NVSL/Quadcopters/Class/Tutorial Photos/2-16.png

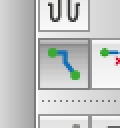
Class/Tutorial Photos/2-16.png
