NVSL/Quadcopters/Class/Tutorial Photos/2-14.png

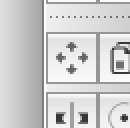
Class/Tutorial Photos/2-14.png
