NVSL/Quadcopters/Class/Slides/04_layers and CAM.pptx

## Layers and CAM

## Layers

- Eagle (and other board design tools) use layers to specify different types of information about a board. E.g:
  - Where wires should go on each physical layer
  - Where wires should not go on each physical layer
  - Documentation
  - Mechanical information
- Eagle defines 52 layers by default
- ‘t’ prefix means top.
- ‘b’ prefix means bottom (displayed mirrored)

## Eagle Layers

Top | Tracks, top side | | 27 | tValues | Component VALUE, top side
Route2 | Inner layer | | 28 | bValues | Component VALUE, bottom side
Route3 | Inner layer | | 29 | tStop | Solder stop mask, top side (gen. autom.) | | Design
Route4 | Inner layer | | 30 | bStop | Solder stop mask, bottom side (gen. Autom.) | | Documentation
Route5 | Inner layer | | 31 | tCream | Solder cream, top side | | Tool guidance
Route6 | Inner layer | | 32 | bCream | Solder cream, bottom side
Route7 | Inner layer | | 33 | tFinish | Finish, top side
Route8 | Inner layer | | 34 | bFinish | Finish, bottom side
Route9 | Inner layer | | 35 | tGlue | Glue mask, top side
Route10 | Inner layer | | 36 | bGlue | Glue mask, bottom side
Route11 | Inner layer | | 37 | tTest | Test and adjustment information, top side
Route12 | Inner layer | | 38 | bTest | Test and adjustment inf., bottom side
Route13 | Inner layer | | 39 | tKeepout | Restricted areas for components, top side
Route14 | Inner layer | | 40 | bKeepout | Restricted areas for components, bottom s.
Route15 | Inner layer | | 41 | tRestrict | Restricted areas for copper, top side
Bottom | Tracks, bottom side | | 42 | bRestrict | Restricted areas for copper, bottom side
Pads | Pads (through-hole) | | 43 | vRestrict | Restricted areas for vias
Vias | Vias (through all layers) | | 44 | Drills | Conducting through-holes
Unrouted | Airlines (rubber bands) | | 45 | Holes | Non-conducting holes
Dimension | Board outlines (circles for holes) *) | | 46 | Milling | Milling
tPlace | Silk screen, top side | | 47 | Measures | Measures
bPlace | Silk screen, bottom side | | 48 | Document | Documentation
tOrigins | Origins, top side (generated autom.) | | 49 | Reference | Reference marks
bOrigins | Origins, bottom side (generated autom.) | | 51 | tDocu | Detailed top screen print
tNames | Service print, top side (component NAME) | | 52 | bDocu | Detailed bottom screen print
bNames | Service print, bottom s. (component NAME)

## Layer Demo

## Layers In Packages

- Packages have layers too, but not all of them
  - E.g. no inner metal layers
- For packages “t” means device side, “b” means opposite side.
- If you put the devices on the back side of the board, “t” and “b” will swap.

## CAM Layers (Gerber files)

- Eagle layers are for design.
- CAM layers are for manufacturing
  - “Gerber” files are for lithographic steps
  - Drill files are for drilling holes.
- Each CAM layers corresponds to one layer of the resulting board
  - Top silk screen
  - Top solder mask
  - Top metal
  - Inner metal layers
  - Bottom metal
  - Bottom solder mask
  - Bottom silk screen
- One drill file specifying where all the pads, vias, and mounting holes are located and their diameters
- Other files too, depending on the manufacturing process
  - Solder paste stencil
  - Assembly drawings

## The CAM Processor

- The CAM Processor generates CAM files
- The exact configuration for the gerber files varies by board house
  - Should the board outline be in every layer?
  - Which format should the files be in (there are many)
  - Should the back side layers be mirrored?

## CAM Setup

- To prepare Gerbers for a particular board house, you need CAM setup files (*.cam for Eagle)
- This specifies how to generate each layer the board house needs.
- See example in Button and Light Tutorial.

## CAM Demo

## Checking Your Gerbers!

- Eagle can’t display Gerber files itself
- You need a 3rd party tool
  - See the Button and Light tutorial for recommendations
- You should always check your Gerbers!
  - Eagle has bugs (I assume)
  - You may have misconfigured something
  - You may have put something in the wrong layer.

## Gerber Viewer Demo

## DFM Checks

- You should also run a “design for manufacturing” (DFM) check on your Gerbers, if possible
- Freedfm.com will do this for you.

## FreeDFM Demo
