NVSL/Quadcopters/Master/Jorge/REV0/GERBER_master_jorge3newIMU/readme.txt

>Info
Board Name: UCSDQuadCop
Part Number: 0
Number of Layers: 2
X Dimension= 2.83 inch
Y Dimension= 2.90 inch
Board Material Type: FR-4
Solder Mask Color: Red
Silkscreen Color: White
Finish Plating: HASAL
Revision Number: 0
