NVSL/Quadcopters/Class/Slides/I2C.key/Data/pasted-image-190.tif

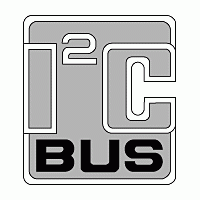
Class/Slides/I2C.key/Data/pasted-image-190.tif
