NVSL/Quadcopters/Class/Slides/I2C.key/Data/pasted-image-379.tif

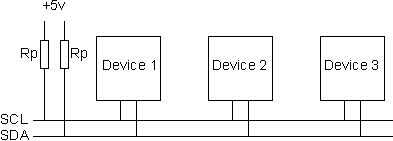
Class/Slides/I2C.key/Data/pasted-image-379.tif
