NVSL/Quadcopters/Class/Slides/I2C.key/Data/pasted-image-653.tif

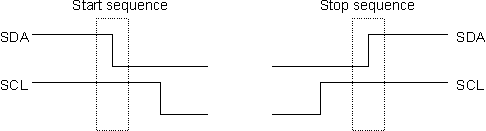
Class/Slides/I2C.key/Data/pasted-image-653.tif
