NVSL/Quadcopters/Class/Slides/I2C.key/Data/pasted-image-1346.tif

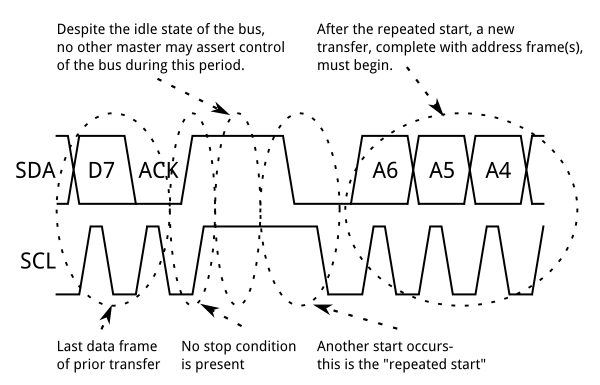
Class/Slides/I2C.key/Data/pasted-image-1346.tif
