NVSL/Quadcopters/Class/Slides/I2C.key/Data/pasted-image-small-1347.png

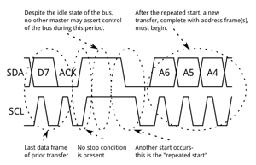
Class/Slides/I2C.key/Data/pasted-image-small-1347.png
