NVSL/Quadcopters/Class/Slides/I2C.key/Data/Screen Shot 2014-10-18 at 3.31.50 PM-908.png

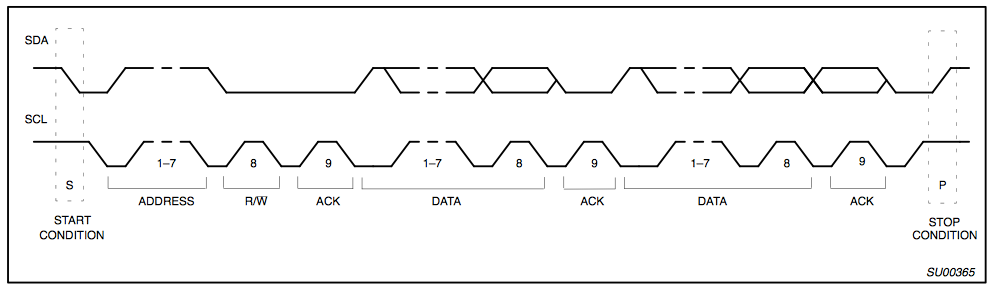
Class/Slides/I2C.key/Data/Screen Shot 2014-10-18 at 3.31.50 PM-908.png
