NVSL/Quadcopters/Class/Slides/I2C.key/Data/Screen Shot 2014-10-18 at 5.25.19 PM-1253.png

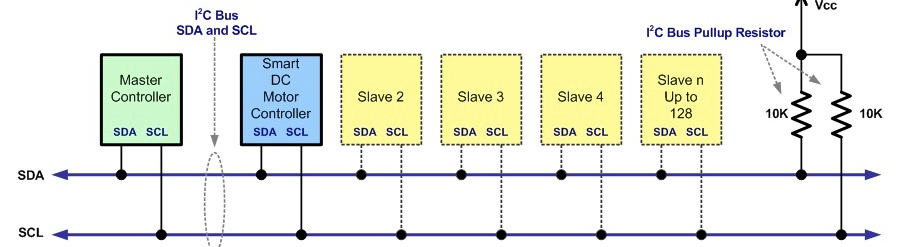
Class/Slides/I2C.key/Data/Screen Shot 2014-10-18 at 5.25.19 PM-1253.png
