NVSL/Quadcopters/Class/Slides/I2C.key/Data/st1-1359.jpg

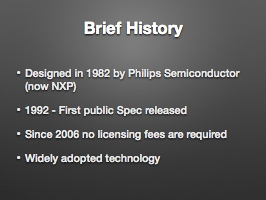
Class/Slides/I2C.key/Data/st1-1359.jpg
