NVSL/Quadcopters/Class/Slides/I2C.key/Data/st2-488.jpg

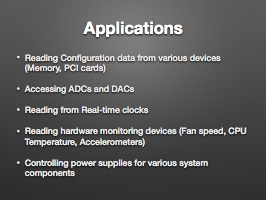
Class/Slides/I2C.key/Data/st2-488.jpg
