NVSL/Quadcopters/Class/Slides/I2C.key/Data/st4-532.jpg

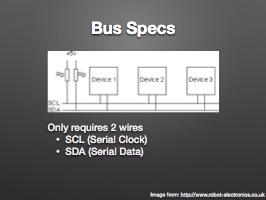
Class/Slides/I2C.key/Data/st4-532.jpg
