NVSL/Quadcopters/Class/Slides/I2C.key/Data/st6-1366.jpg

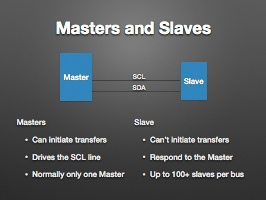
Class/Slides/I2C.key/Data/st6-1366.jpg
