NVSL/Quadcopters/Class/Slides/I2C.key/Data/st7-711.jpg

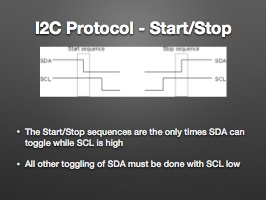
Class/Slides/I2C.key/Data/st7-711.jpg
