NVSL/Quadcopters/Class/Slides/I2C.key/Data/st8-843.jpg

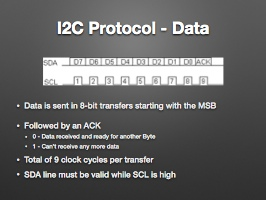
Class/Slides/I2C.key/Data/st8-843.jpg
