NVSL/Quadcopters/Class/Slides/I2C.key/Data/st9-896.jpg

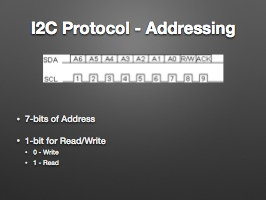
Class/Slides/I2C.key/Data/st9-896.jpg
