NVSL/Quadcopters/Class/Slides/I2C.key/Data/st10-1140.jpg

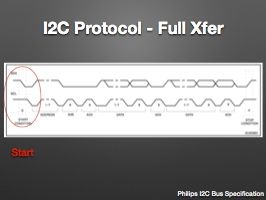
Class/Slides/I2C.key/Data/st10-1140.jpg
