NVSL/Quadcopters/Class/Slides/I2C.key/Data/st10-1331.jpg

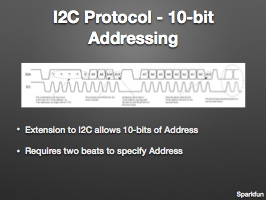
Class/Slides/I2C.key/Data/st10-1331.jpg
