NVSL/Quadcopters/Class/Slides/I2C.key/Data/st12-1098.jpg

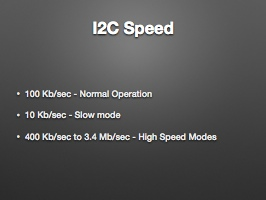
Class/Slides/I2C.key/Data/st12-1098.jpg
