NVSL/Quadcopters/Class/Slides/I2C.key/Data/st12-1168.jpg

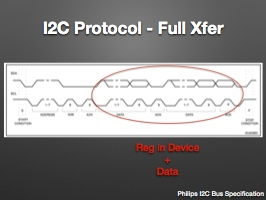
Class/Slides/I2C.key/Data/st12-1168.jpg
