NVSL/Quadcopters/Class/Slides/I2C.key/Data/st15-1349.jpg

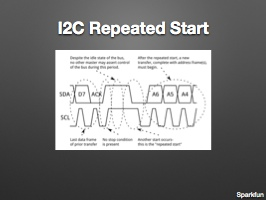
Class/Slides/I2C.key/Data/st15-1349.jpg
