NVSL/Quadcopters/Class/Slides/I2C.key/Data/st17-1248.jpg

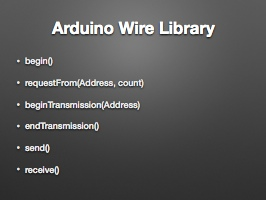
Class/Slides/I2C.key/Data/st17-1248.jpg
