NVSL/Quadcopters/Class/Slides/I2C.key/Data/st17-1279.jpg

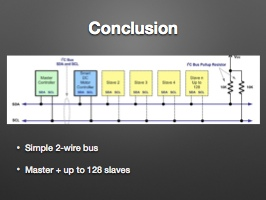
Class/Slides/I2C.key/Data/st17-1279.jpg
