NVSL/Quadcopters/Controller/controller_faceplate.dxf

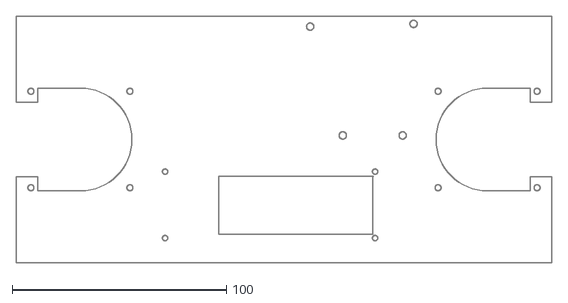
[picture p42: CAD file, 2015-02-03]
Controller/controller_faceplate.dxf
250.0 x 115.0
