NVSL/Quadcopters/Controller/Eagle/Projects/Controller_acrylic/controller_top.dxf

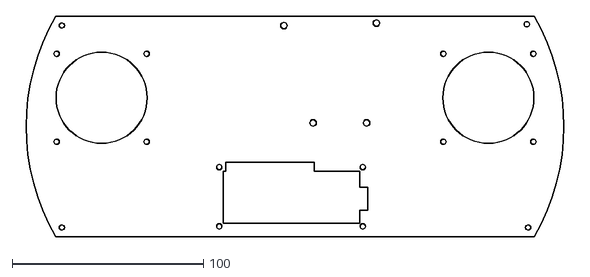
[picture p43: CAD file, 2015-03-24]
Controller/Eagle/Projects/Controller_acrylic/controller_top.dxf
291.1 x 115.0
