NVSL/Quadcopters/Controller/Eagle/Projects/Controller_acrylic/controller_bottom.dxf

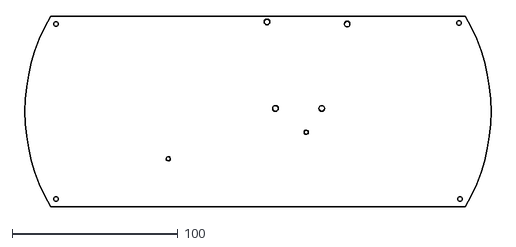
[picture p44: CAD file, 2015-03-24]
Controller/Eagle/Projects/Controller_acrylic/controller_bottom.dxf
291.1 x 115.0
