NVSL/Quadcopters/Class/Tutorial Photos/2-1.png

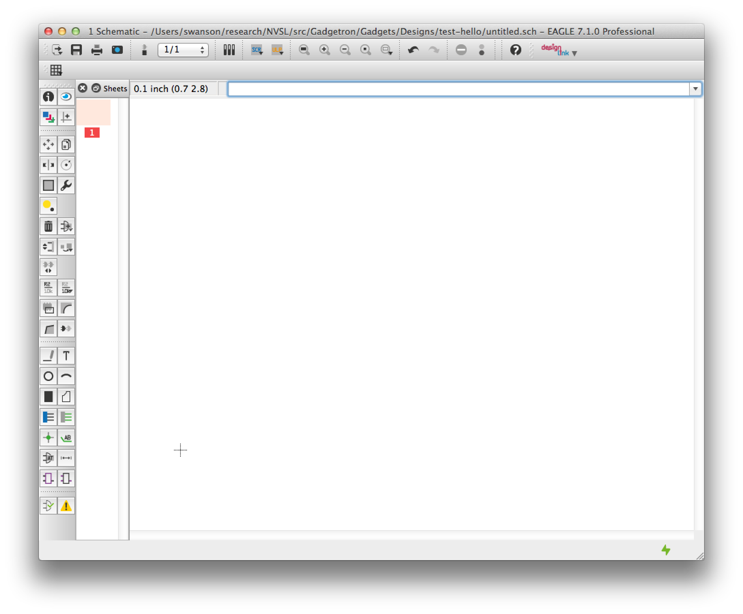
Class/Tutorial Photos/2-1.png
