NVSL/Quadcopters/Class/Tutorial Photos/2-3.png

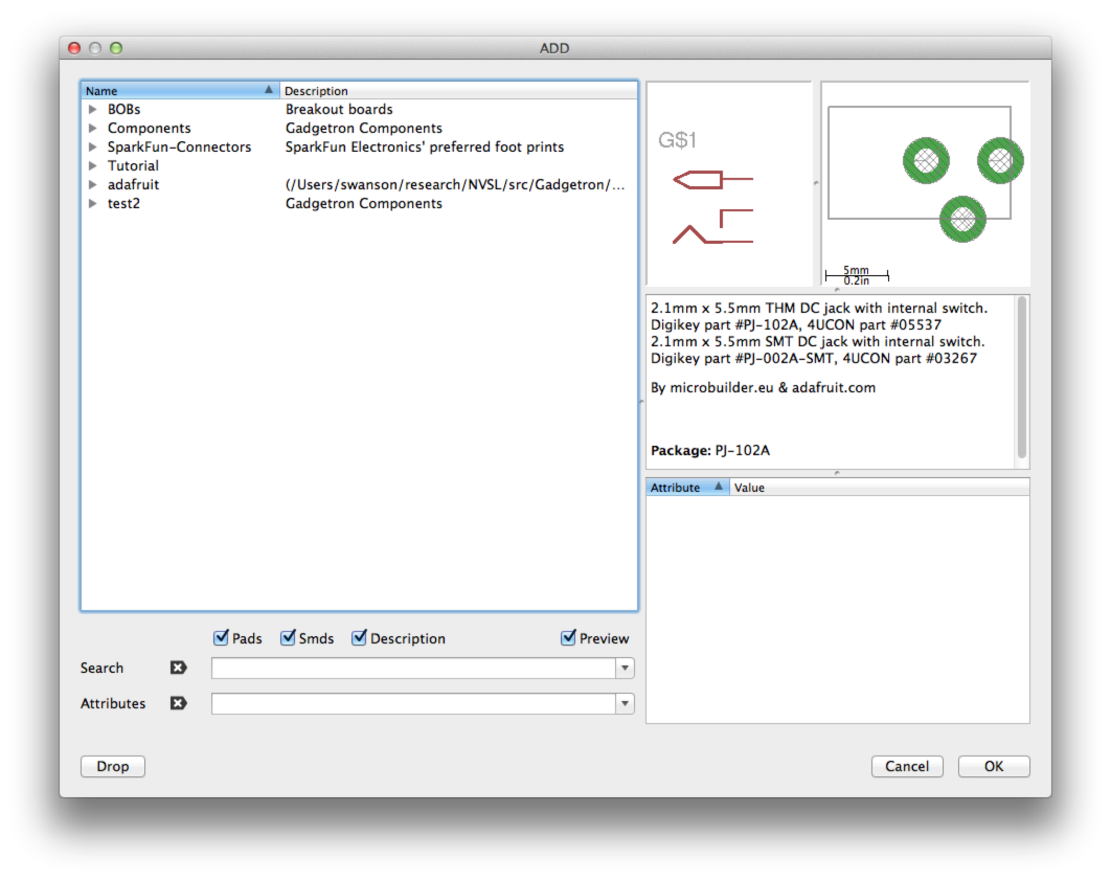
Class/Tutorial Photos/2-3.png
