NVSL/Quadcopters/Class/Tutorial Photos/2-4.png

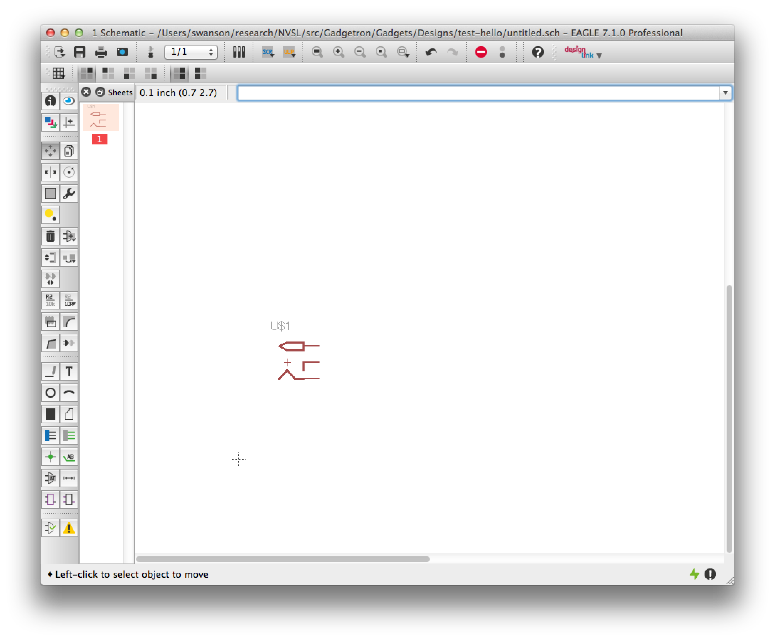
Class/Tutorial Photos/2-4.png
