NVSL/Quadcopters/Class/Tutorial Photos/2-5.png

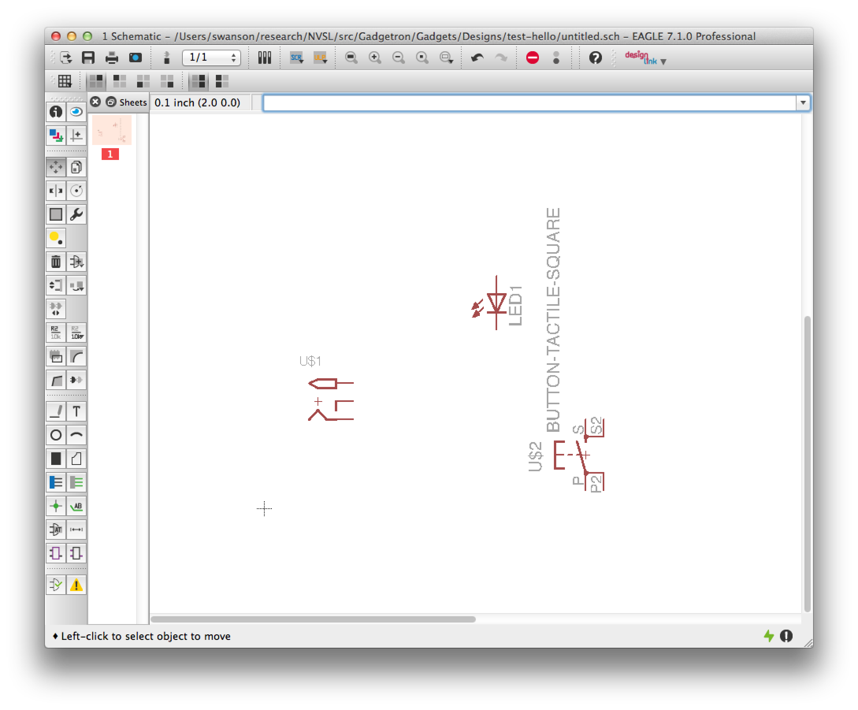
Class/Tutorial Photos/2-5.png
