NVSL/Quadcopters/Class/Tutorial Photos/2-7.png

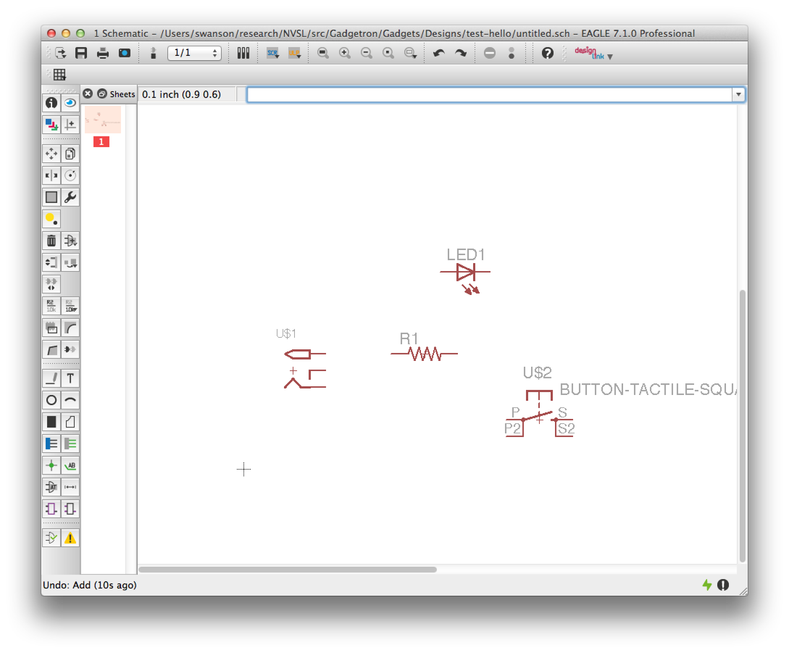
Class/Tutorial Photos/2-7.png
