NVSL/Quadcopters/Class/Tutorial Photos/2-12.png

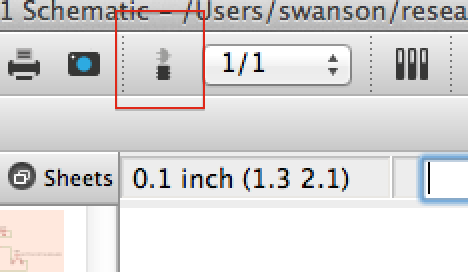
Class/Tutorial Photos/2-12.png
