NVSL/Quadcopters/Class/Tutorial Photos/2-13.png

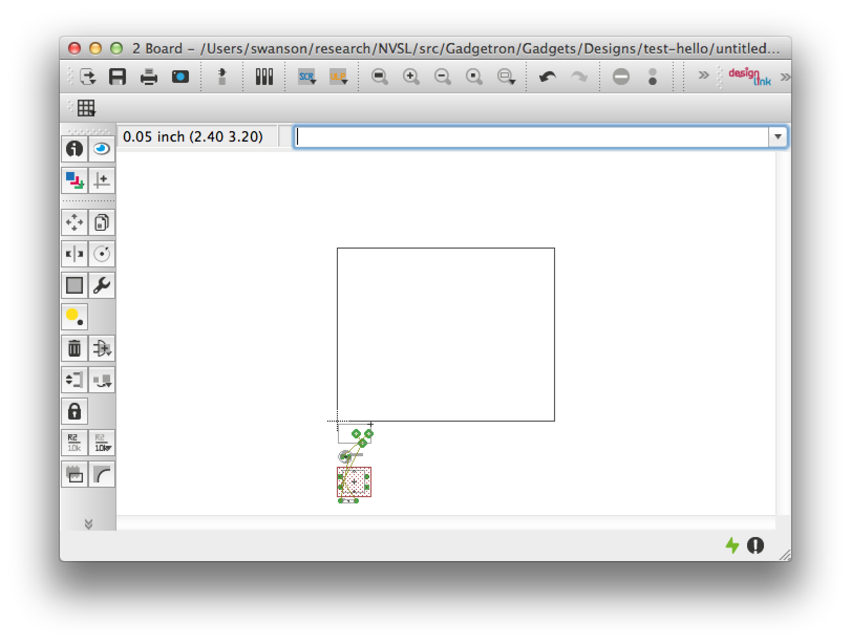
Class/Tutorial Photos/2-13.png
