NVSL/Quadcopters/Class/Tutorial Photos/2-15.png

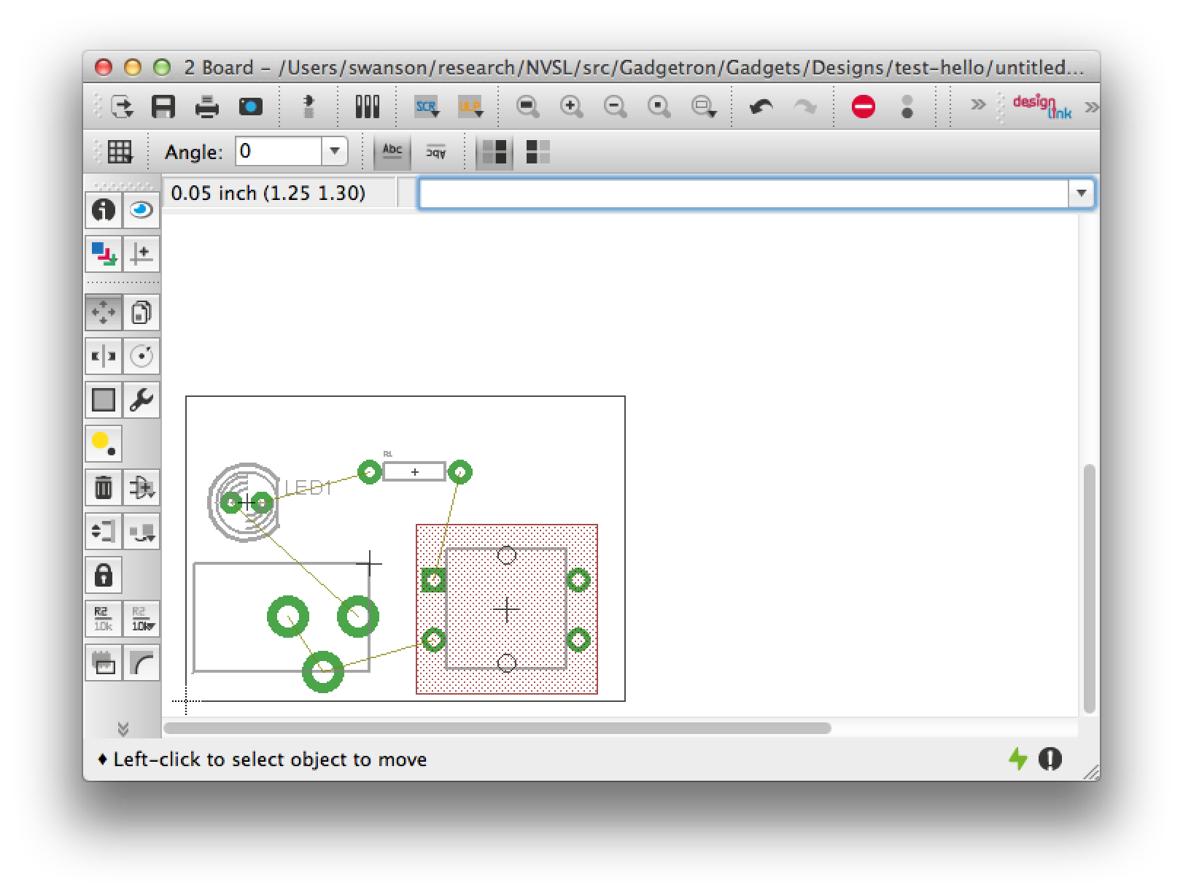
Class/Tutorial Photos/2-15.png
