NVSL/Quadcopters/Class/Tutorial Photos/2-17.png

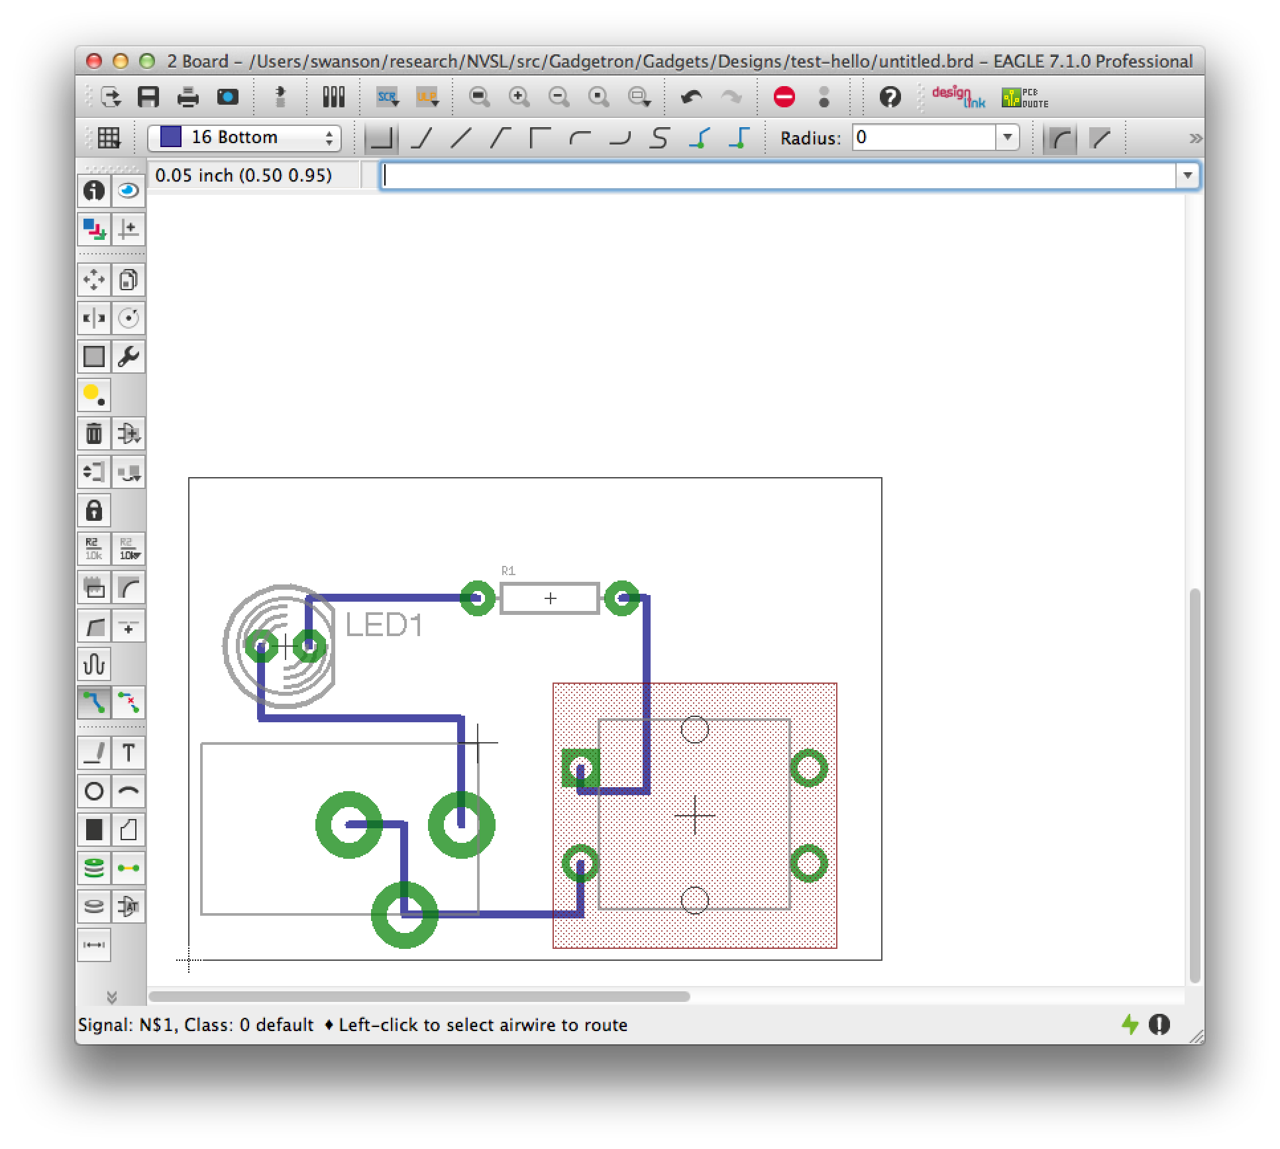
Class/Tutorial Photos/2-17.png
