NVSL/Quadcopters/Class/Tutorial Photos/2-18.png

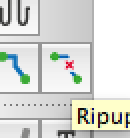
Class/Tutorial Photos/2-18.png
