NVSL/Quadcopters/Class/Tutorial Photos/2-19.png

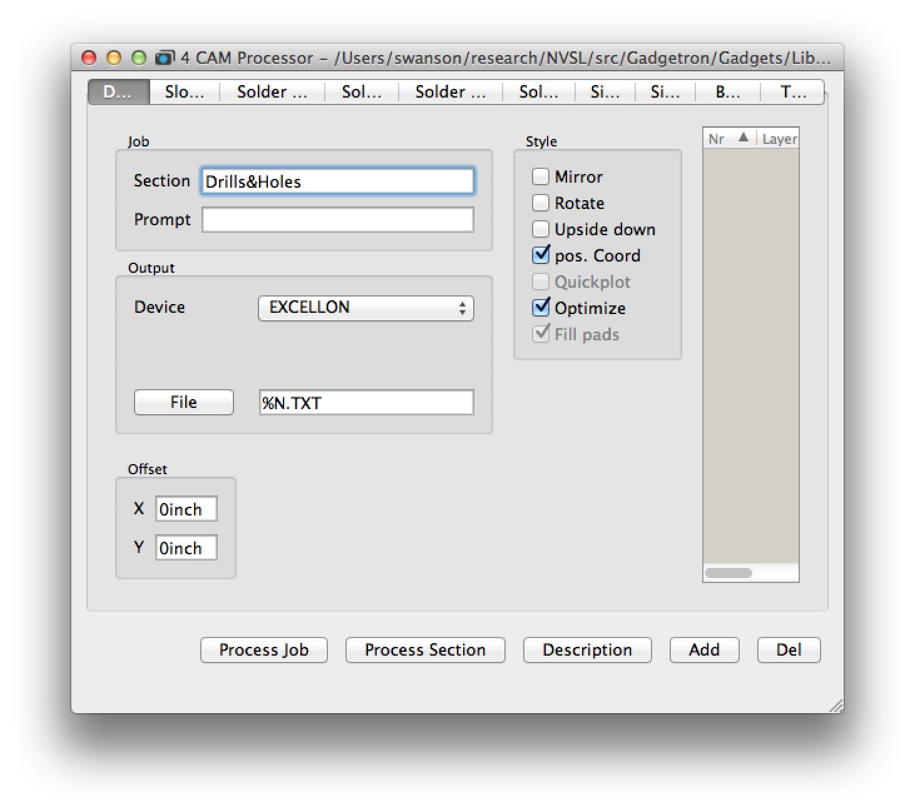
Class/Tutorial Photos/2-19.png
