NVSL/Quadcopters/Class/Tutorial Photos/2-20.png

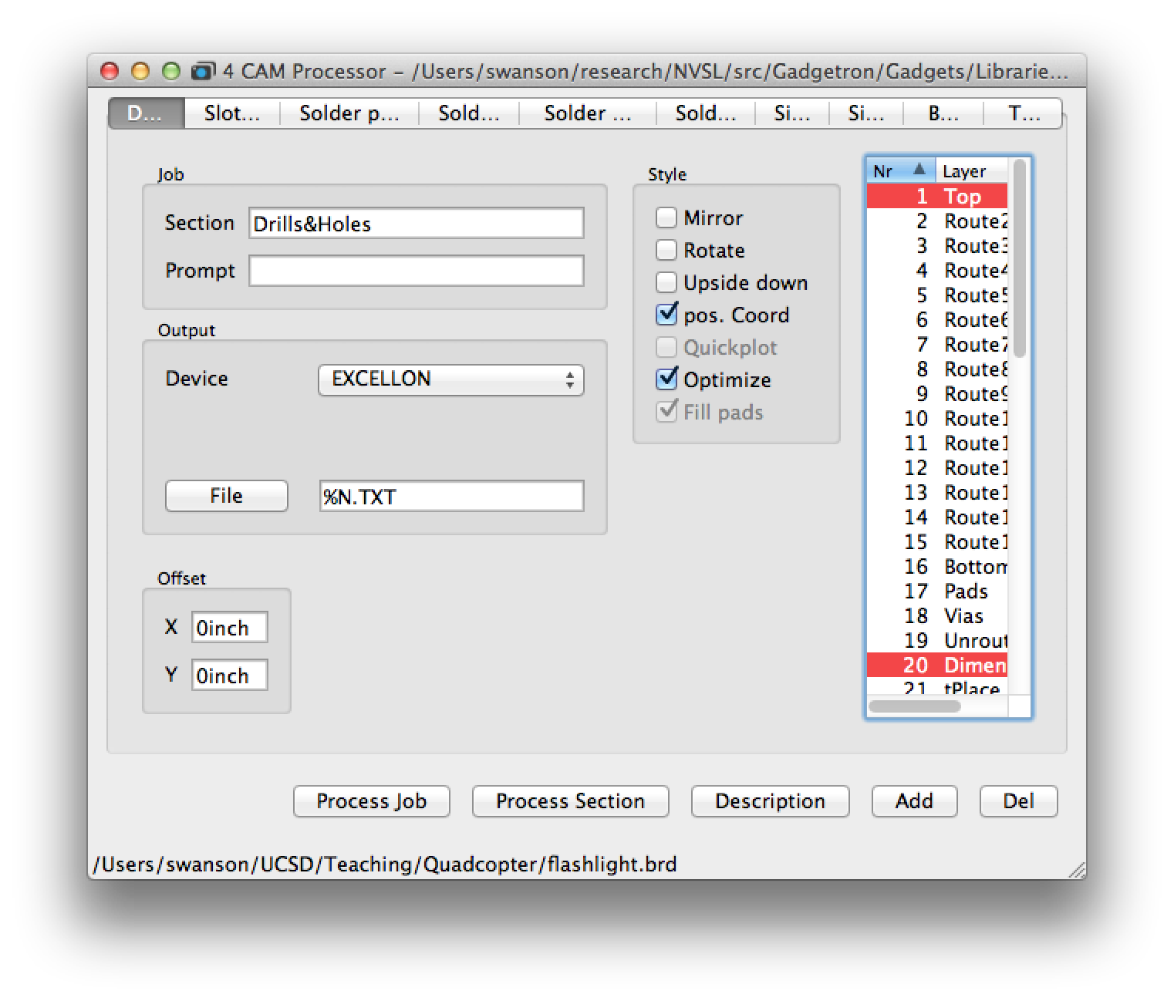
Class/Tutorial Photos/2-20.png
