NVSL/Quadcopters/Class/Tutorial Photos/2-21.png

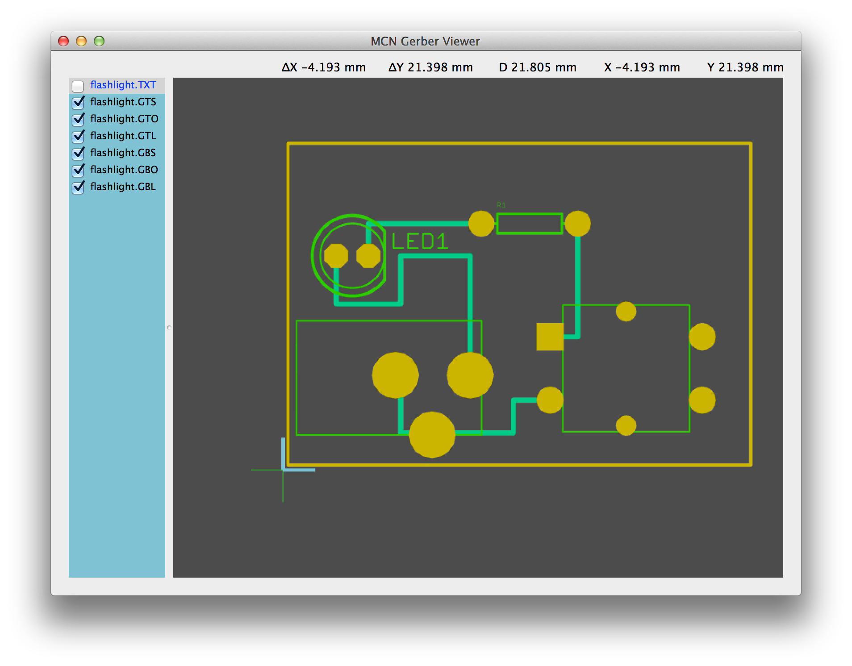
Class/Tutorial Photos/2-21.png
