NVSL/Quadcopters/Class/Tutorial Photos/2-23.png

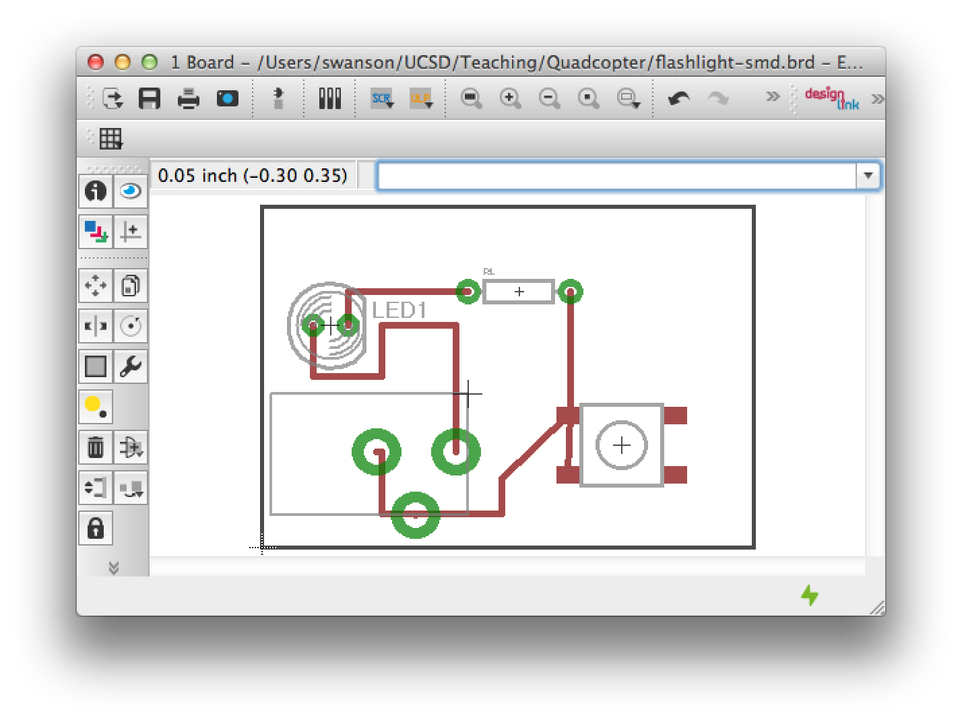
Class/Tutorial Photos/2-23.png
