NVSL/Quadcopters/Class/Tutorial Photos/2-25.png

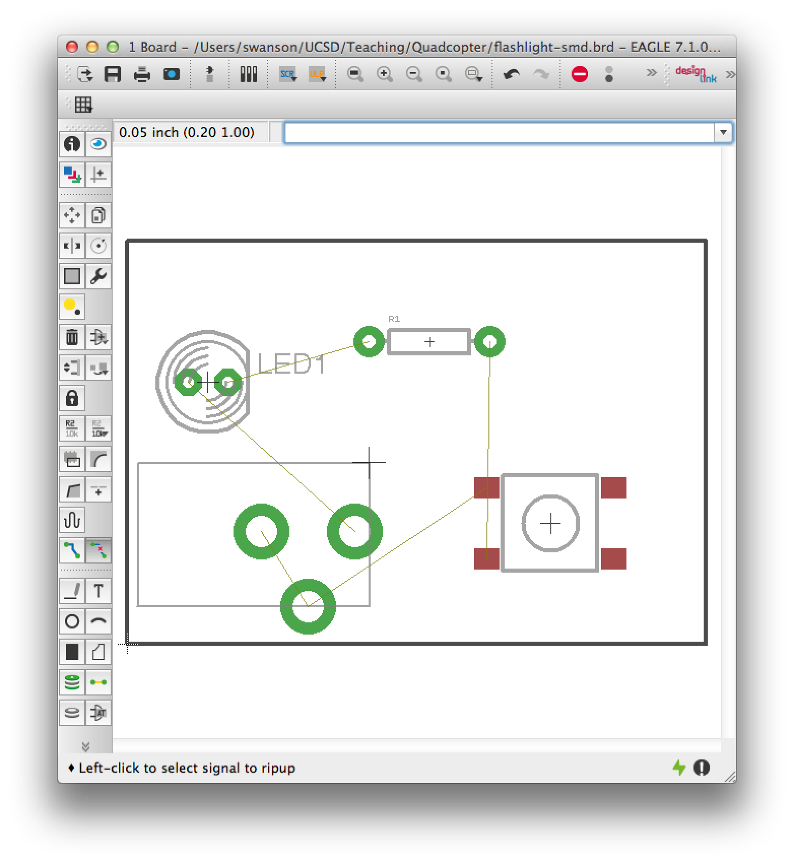
Class/Tutorial Photos/2-25.png
