NVSL/Quadcopters/Class/Tutorial Photos/2-26.png

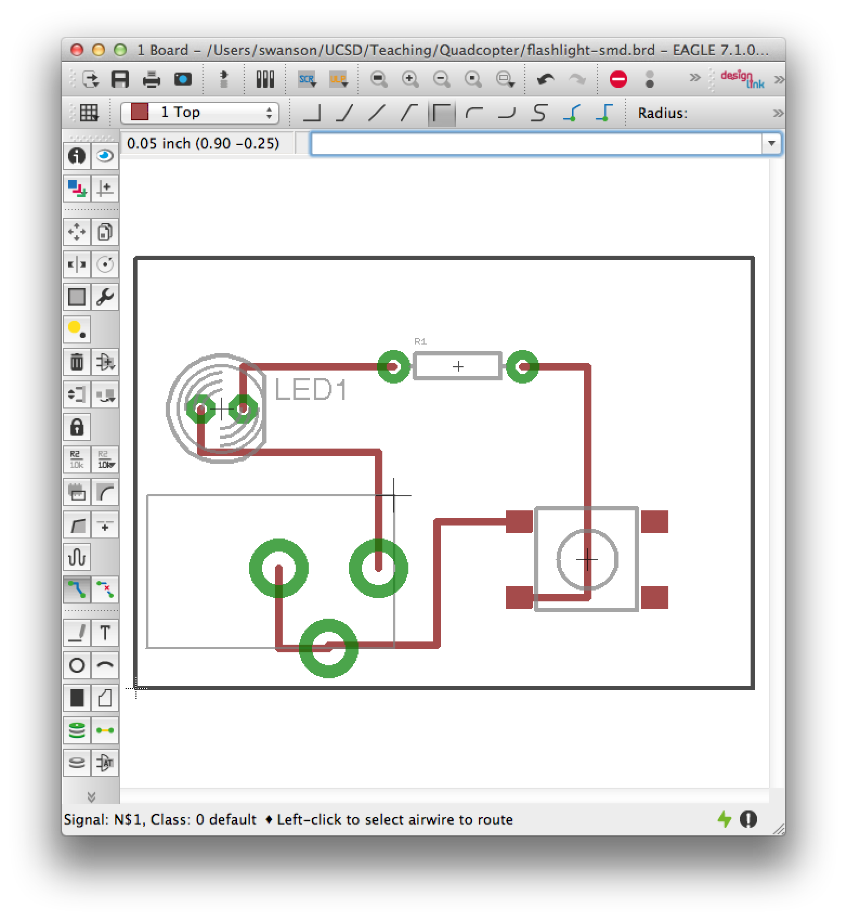
Class/Tutorial Photos/2-26.png
