NVSL/Quadcopters/Class/Tutorial Photos/2-28.png

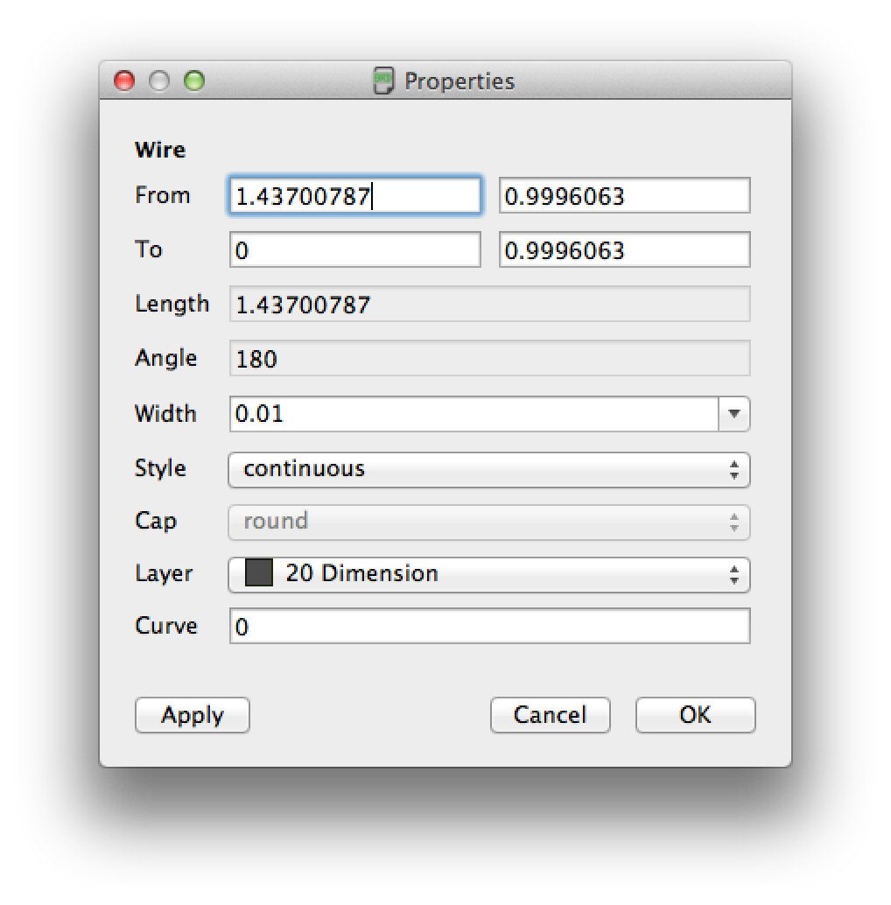
Class/Tutorial Photos/2-28.png
