NVSL/Quadcopters/Class/Tutorial Photos/2-30.png

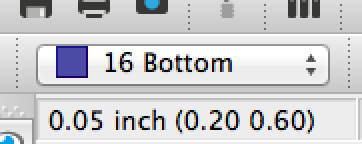
Class/Tutorial Photos/2-30.png
