NVSL/Quadcopters/Class/Tutorial Photos/2-31.png

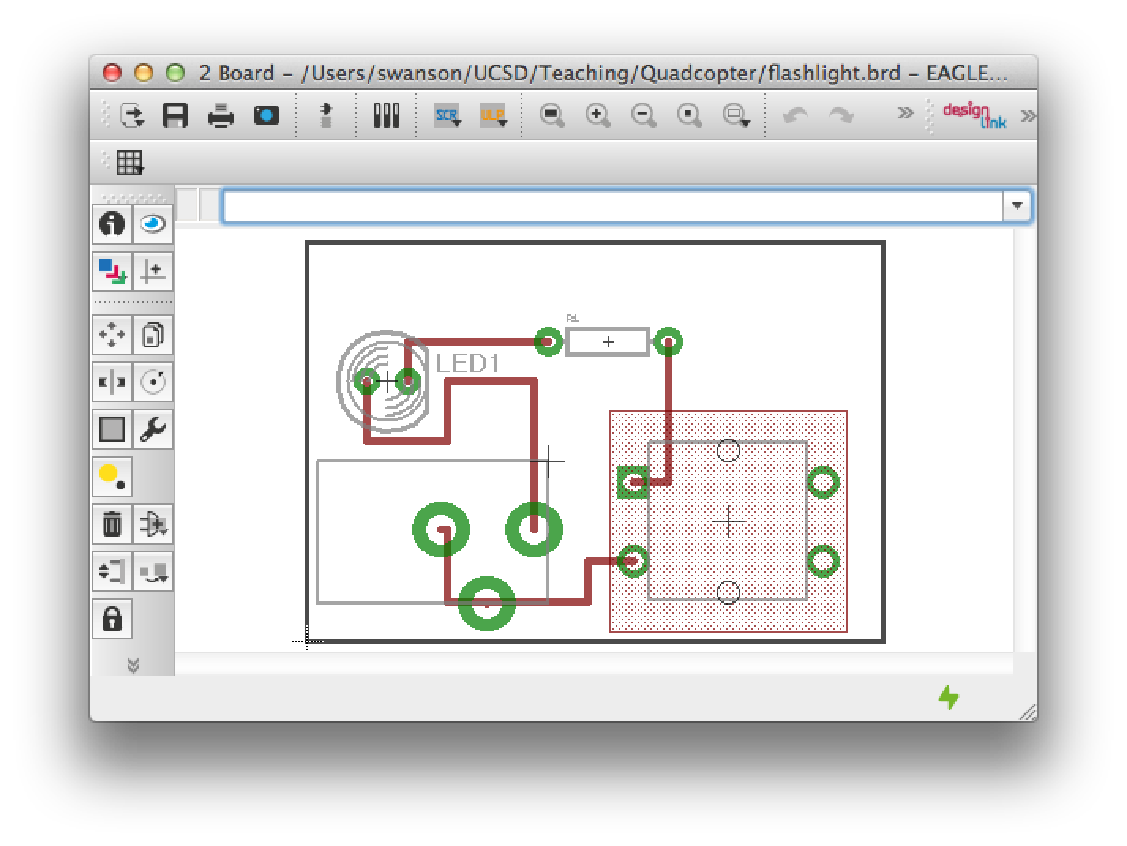
Class/Tutorial Photos/2-31.png
