NVSL/Quadcopters/Class/Tutorial Photos/2-33.png

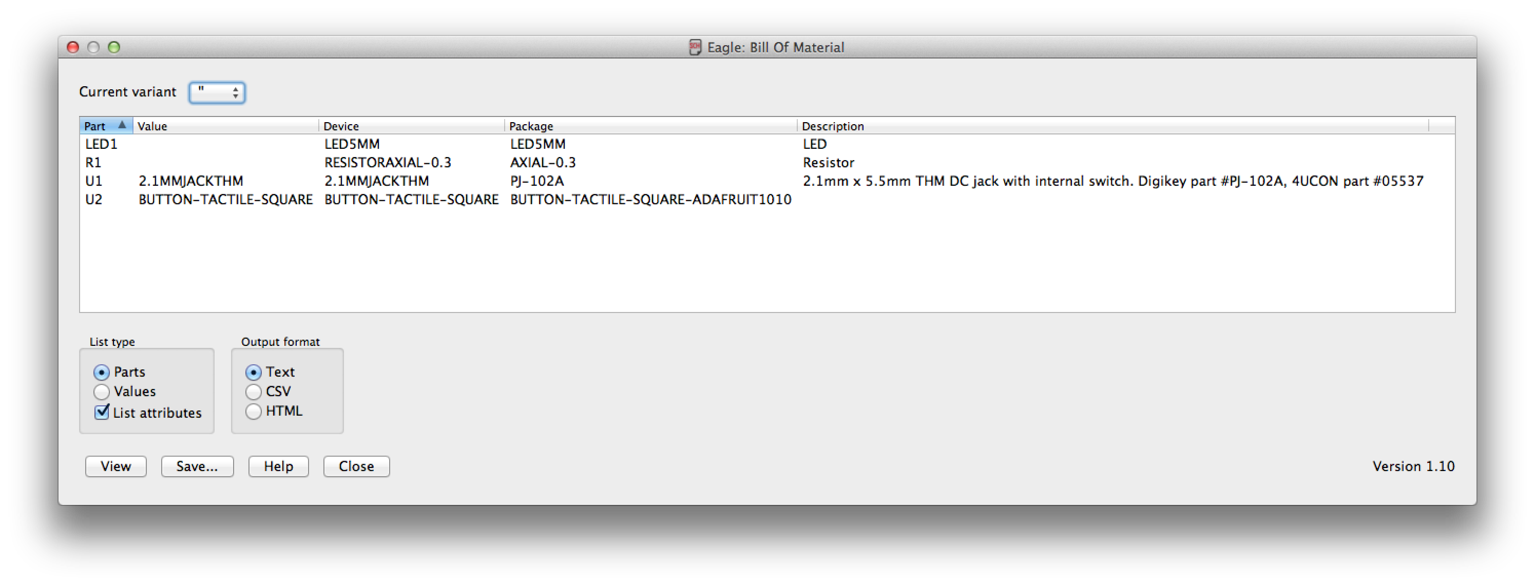
Class/Tutorial Photos/2-33.png
