NVSL/Quadcopters/Class/Tutorial Photos/2-34.png

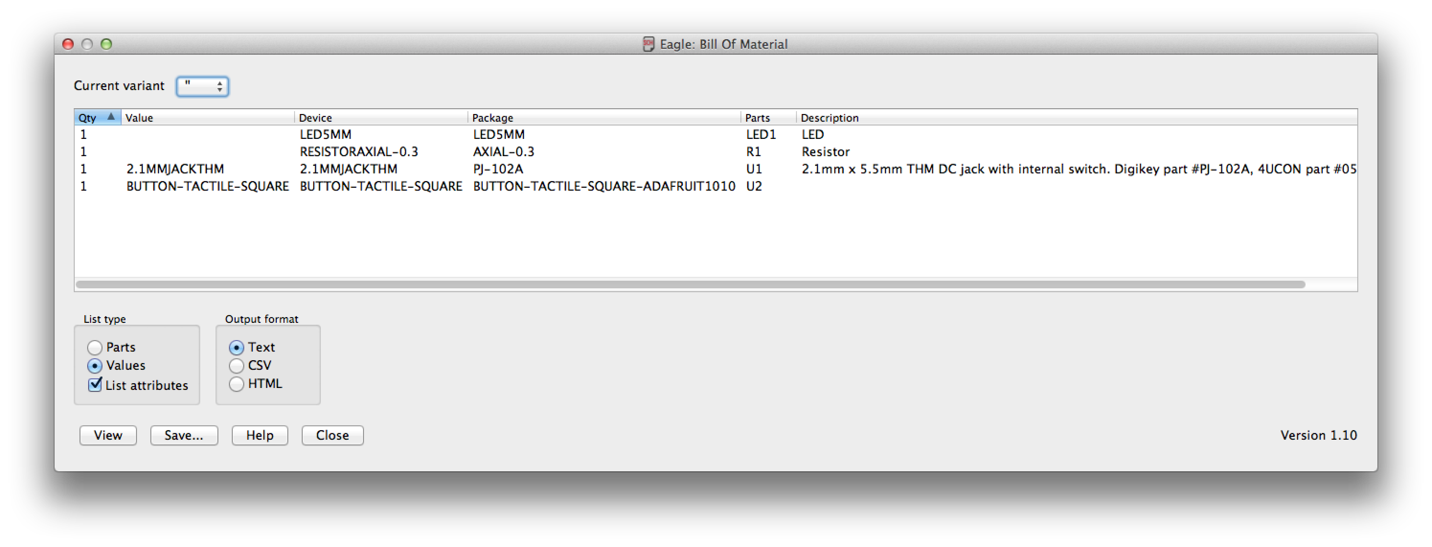
Class/Tutorial Photos/2-34.png
