NVSL/Quadcopters/Master/Jorge/REV1/UCSD_QuadCopter_Rev1.brd

## EAGLE design Master/Jorge/REV1/UCSD_QuadCopter_Rev1.brd (2015-04-28)

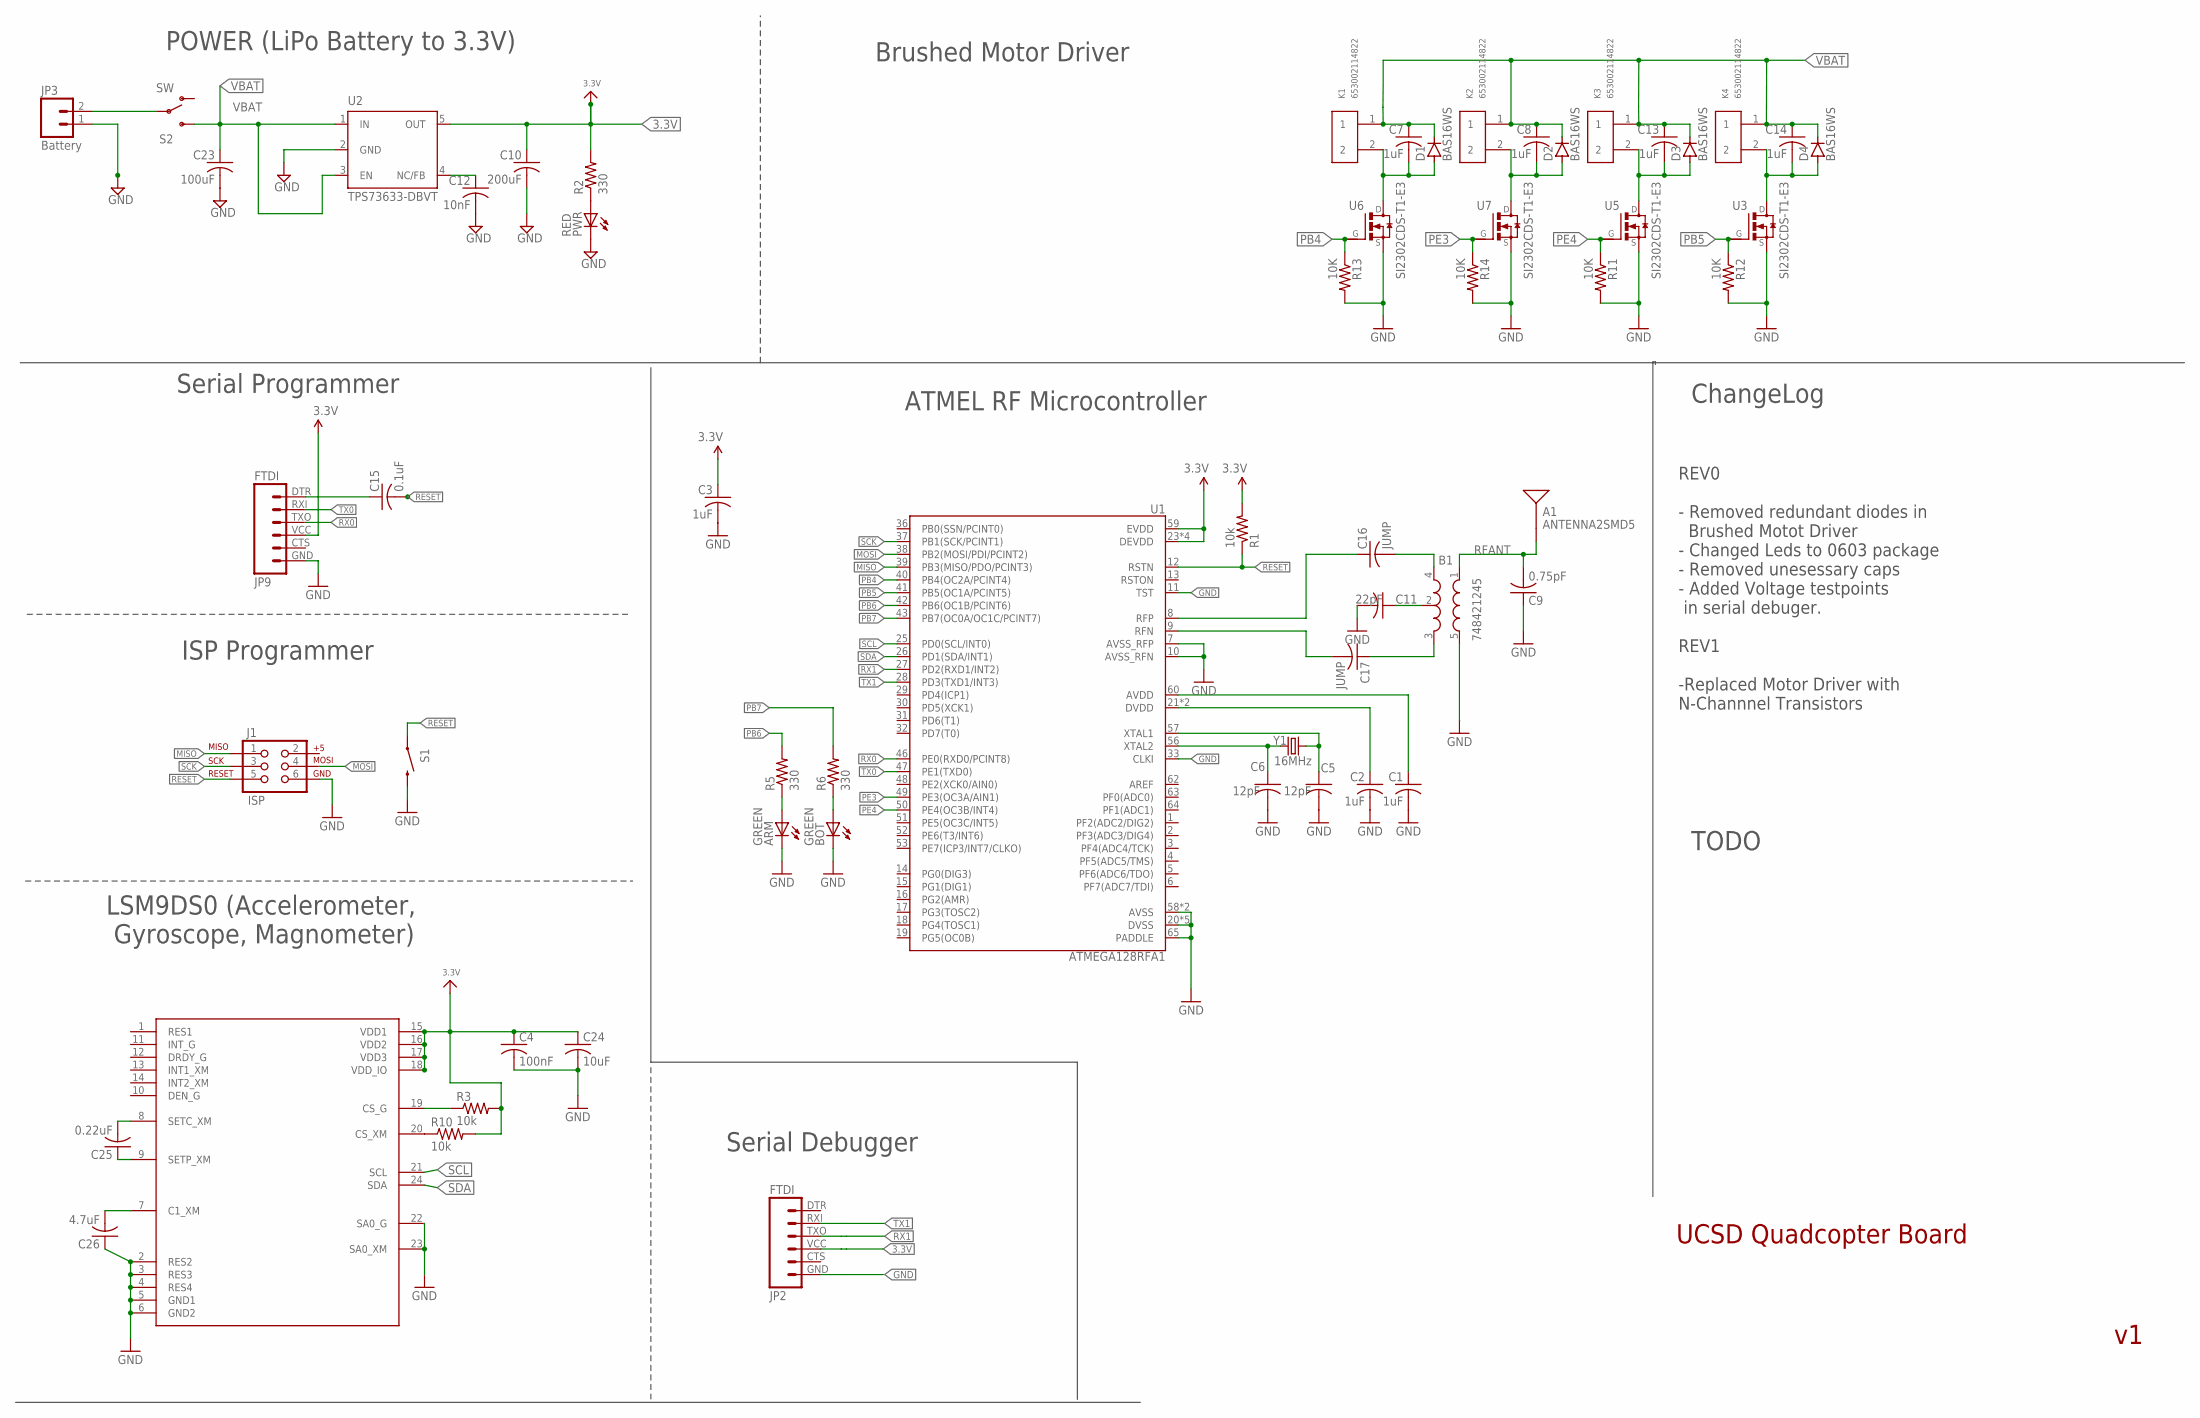
[picture p66: schematic UCSD_QuadCopter_Rev1.sch]

Parts:
A1: ANTENNA2SMD5; ANTENNA-CHIP5
ARM: GREEN; CHIP-LED0805
B1: 748421245; BALUN
BOT: GREEN; CHIP-LED0805
C1, C2, C3, C7, C8, C13, C14: 1uF; C0805
C4: 100nF; C0805
C5, C6: 12pF; C0805
C9: 0.75pF; C0805
C10: 200uF; C0805
C11: 22pF; C0805
C12: 10nF; C0805
C15: 0.1uF; C0805
C16, C17: JUMP; C0805
C23: 100uF; C0805
C24: 10uF; C0805
C25: 0.22uF; C0805
C26: 4.7uF; C0805
D1, D2, D3, D4: BAS16WS; SOD323_ST
J1: ISP; 2X3-NS
JP2, JP9: FTDI; FTDI_BASIC
JP3: Battery; 1X02
K1, K2, K3, K4: 653002114822
PWR: RED; CHIP-LED0805
R1, R3, R10: 10k; R0805
R2, R5, R6: 330; R0805
R11, R12, R13, R14: 10K; R0805
S1: SWITCH-MOMENTARY-2SMD; TACTILE_SWITCH_SMD
S2: SW; SWITCH-SPDT
U1: ATMEGA128RFA1; QFN-64
U2: TPS73633-DBVT; SOT23-DBV
U3, U5, U6, U7: SI2302CDS-T1-E3; SOT95P237X112-3N
U4: LSM9DS0; LGA-24
Y1: 16MHz; CRYSTAL-SMD-5X3

Connections:
3.3V: C3.1, C4.1, C10.1, C24.1, JP2.VCC (4), JP9.VCC (4), R1.2, R2.2, R3.2, R10.2, U1.23 (DEVDD), U1.34 (DEVDD), U1.44 (DEVDD), U1.54 (DEVDD), U1.59 (EVDD), U2.5 (OUT), U4.15 (VDD1), U4.16 (VDD2), U4.17 (VDD3), U4.18 (VDD_IO)
AVDD: C1.1, U1.60 (AVDD)
DTR: C15.1, JP9.DTR (1)
DVDD: C2.1, U1.21 (DVDD), U1.22 (DVDD)
GND: ARM.C, B1.5 (GND), BOT.C, C1.2, C2.2, C3.2, C4.2, C5.2, C6.2, C9.1, C10.2, C11.2, C12.2, C23.2, C24.2, C26.1, J1.6, JP2.GND (6), JP3.1, JP9.GND (6), PWR.C, R11.2, R12.2, R13.2, R14.2, S1.3 (2), U1.7 (AVSS_RFP), U1.10 (AVSS_RFN), U1.11 (TST), U1.20 (DVSS), U1.24 (DVSS), U1.33 (CLKI), U1.35 (DVSS), U1.45 (DVSS), U1.55 (DVSS), U1.58 (AVSS), U1.61 (AVSS), U1.65 (PADDLE), U2.2 (GND), U3.2 (S), U4.2 (RES2), U4.3 (RES3), U4.4 (RES4), U4.5 (GND1), U4.6 (GND2), U4.22 (SA0_G), U4.23 (SA0_XM), U5.2 (S), U6.2 (S), U7.2 (S)
MISO: J1.1, U1.39 (PB3(MISO/PDO/PCINT3))
MOSI: J1.4, U1.38 (PB2(MOSI/PDI/PCINT2))
unnamed: C12.1, U2.4 (NC/FB)
unnamed: PWR.A, R2.1
unnamed: C5.1, U1.57 (XTAL1), Y1.3 (2)
unnamed: C6.1, U1.56 (XTAL2), Y1.1
unnamed: B1.2 (GND), C11.1
unnamed: ARM.A, R5.1
unnamed: B1.4 (OUT1), C16.2
unnamed: B1.3 (OUT2), C17.1
unnamed: BOT.A, R6.1
unnamed: JP3.2, S2.2
unnamed: C26.2, U4.7 (C1_XM)
unnamed: C25.2, U4.8 (SETC_XM)
unnamed: C25.1, U4.9 (SETP_XM)
unnamed: R3.1, U4.19 (CS_G)
unnamed: R10.1, U4.20 (CS_XM)
unnamed: C7.2, D1.A, K1.2, U6.3 (D)
unnamed: C8.2, D2.A, K2.2, U7.3 (D)
unnamed: C13.2, D3.A, K3.2, U5.3 (D)
unnamed: C14.2, D4.A, K4.2, U3.3 (D)
PB4: R13.1, U1.40 (PB4(OC2A/PCINT4)), U6.1 (G)
PB5: R12.1, U1.41 (PB5(OC1A/PCINT5)), U3.1 (G)
PB6: R5.2, U1.42 (PB6(OC1B/PCINT6))
PB7: R6.2, U1.43 (PB7(OC0A/OC1C/PCINT7))
PE3: R14.1, U1.49 (PE3(OC3A/AIN1)), U7.1 (G)
PE4: R11.1, U1.50 (PE4(OC3B/INT4)), U5.1 (G)
RESET: C15.2, J1.5, R1.1, S1.1, U1.12 (RSTN)
RFANT: A1.FEED, B1.1 (IN), C9.2
RFN: C17.2, U1.9 (RFN)
RFP: C16.1, U1.8 (RFP)
RX0: JP9.TXO (3), U1.46 (PE0(RXD0/PCINT8))
RX1: JP2.TXO (3), U1.27 (PD2(RXD1/INT2))
SCK: J1.3, U1.37 (PB1(SCK/PCINT1))
SCL: U1.25 (PD0(SCL/INT0)), U4.21 (SCL)
SDA: U1.26 (PD1(SDA/INT1)), U4.24 (SDA)
TX0: JP9.RXI (2), U1.47 (PE1(TXD0))
TX1: JP2.RXI (2), U1.28 (PD3(TXD1/INT3))
VBAT: C7.1, C8.1, C13.1, C14.1, C23.1, D1.C, D2.C, D3.C, D4.C, K1.1, K2.1, K3.1, K4.1, S2.3 (S), U2.1 (IN), U2.3 (EN)

Notes on the sheet:
LSM9DS0 (Accelerometer, Gyroscope, Magnometer)
POWER (LiPo Battery to 3.3V)
Brushed Motor Driver
UCSD Quadcopter Board
Serial Programmer
ISP Programmer
Serial Debugger
ATMEL RF Microcontroller
ChangeLog
REV0 - Removed redundant diodes in Brushed Motot Driver - Changed Leds to 0603 package - Removed unesessary caps - Added Voltage testpoints in serial debuger. REV1 -Replaced Motor Driver with N-Channnel Transistors
TODO

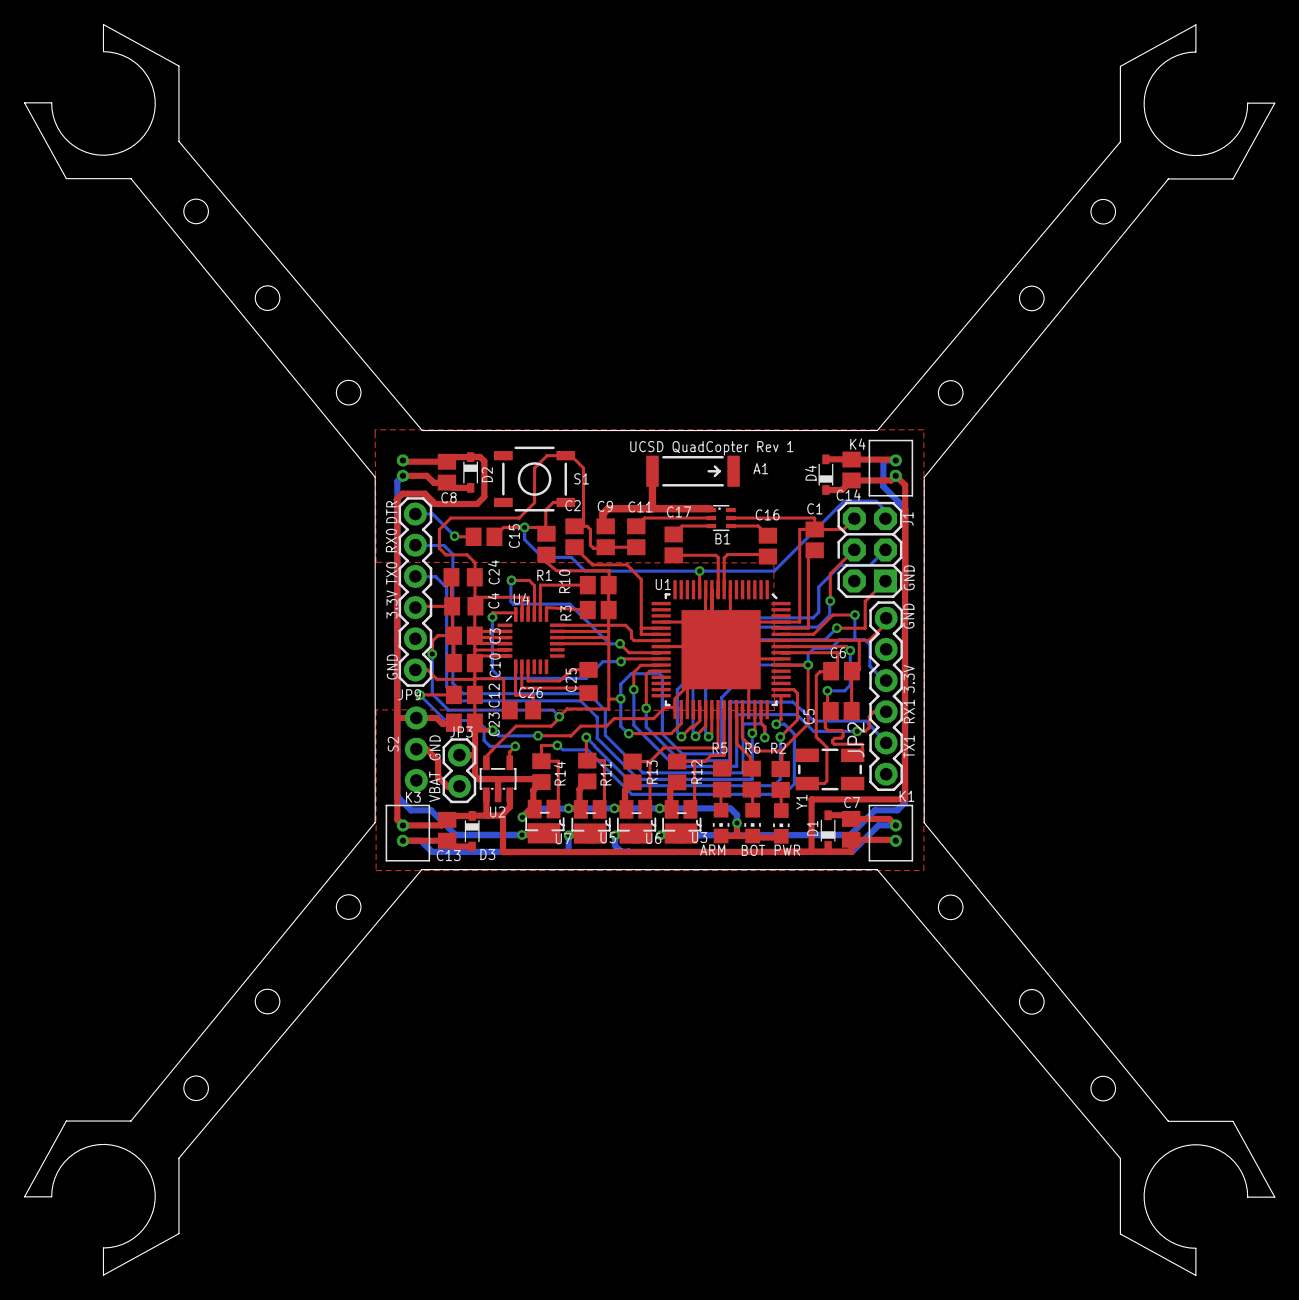
[picture p67: board UCSD_QuadCopter_Rev1.brd from above]

Board: 2 copper layers, 101.8 x 101.9 mm, 58 parts (1 on the bottom side), 44 nets.
