NVSL/Quadcopters/Controller/Eagle/Projects/Controller_acrylic/controller_connect_board.brd

## EAGLE design Controller/Eagle/Projects/Controller_acrylic/controller_connect_board.brd (2015-03-24)

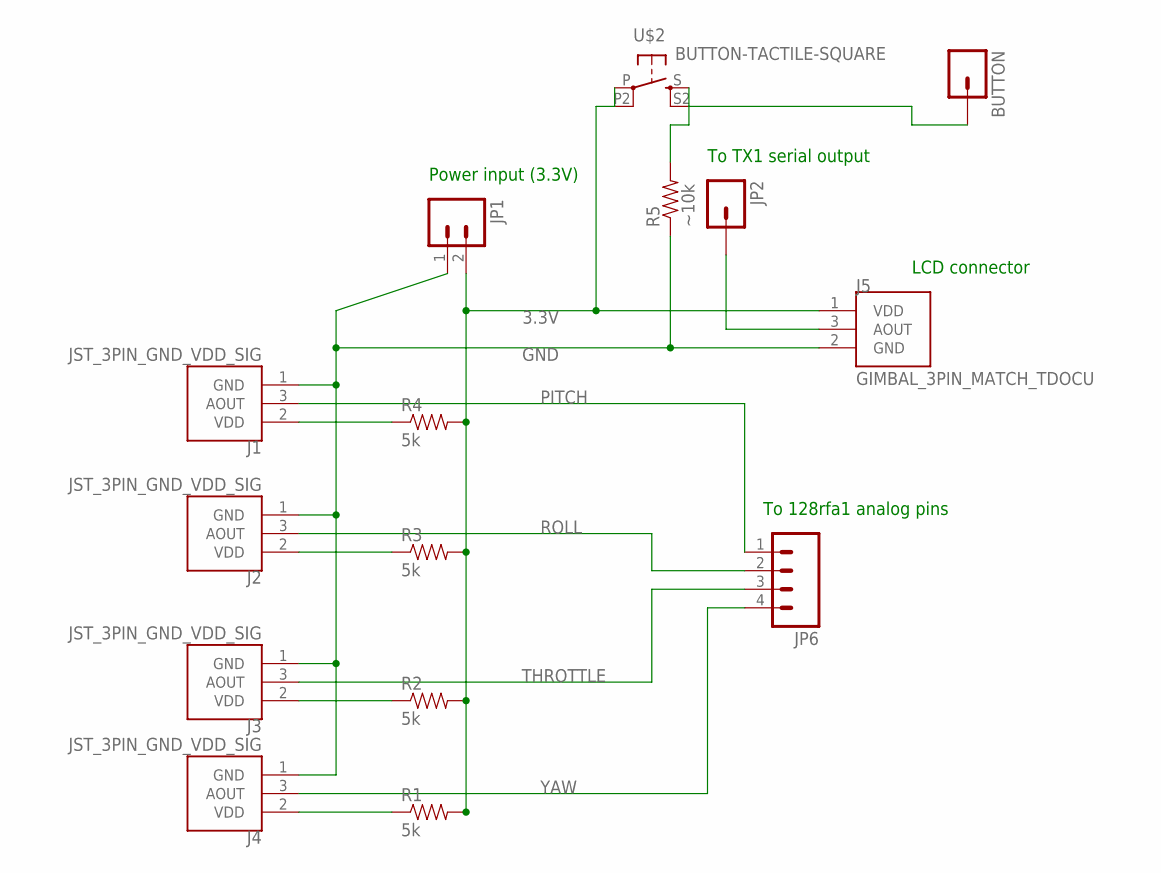
[picture p68: schematic controller_connect_board.sch]

Parts:
BUTTON: M01PTH; 1X01
J1, J2, J3, J4: JST_3PIN_GND_VDD_SIG; JST-3-PTH-REVERSE
J5: GIMBAL_3PIN_MATCH_TDOCU; JST-3-PTH
JP1: M021X02_NO_SILK; 1X02_NO_SILK
JP2: M01PTH; 1X01
JP6: M04PTH; 1X04
R1, R2, R3, R4: 5k; AXIAL-0.4
R5: ~10k; AXIAL-0.4
U$2: BUTTON-TACTILE-SQUARE; BUTTON-TACTILE-SQUARE-ADAFRUIT1010

Connections:
3.3V: J5.1 (VDD), JP1.2, R1.P$2 (2), R2.P$2 (2), R3.P$2 (2), R4.P$2 (2), U$2.P, U$2.P2 (P1)
GND: J1.1 (GND), J2.1 (GND), J3.1 (GND), J4.1 (GND), J5.2 (GND), JP1.1, R5.P$1 (1)
unnamed: J4.2 (VDD), R1.P$1 (1)
unnamed: J3.2 (VDD), R2.P$1 (1)
unnamed: J2.2 (VDD), R3.P$1 (1)
unnamed: J1.2 (VDD), R4.P$1 (1)
unnamed: BUTTON.1, R5.P$2 (2), U$2.S, U$2.S2 (S1)
unnamed: J5.3 (AOUT), JP2.1
PITCH: J1.3 (AOUT), JP6.1
ROLL: J2.3 (AOUT), JP6.2
THROTTLE: J3.3 (AOUT), JP6.3
YAW: J4.3 (AOUT), JP6.4

Notes on the sheet:
Power input (3.3V)
To 128rfa1 analog pins
LCD connector
To TX1 serial output

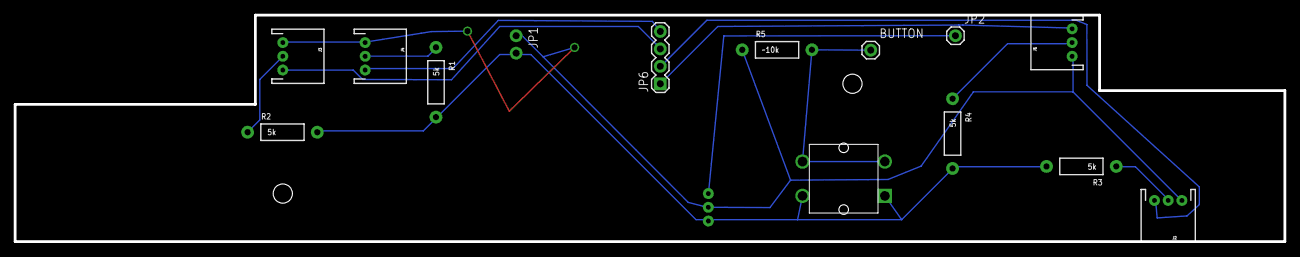
[picture p69: board controller_connect_board.brd from above]

Board: 2 copper layers, 185.0 x 33.0 mm, 16 parts (1 on the bottom side), 12 nets.

Other parts of the board:
U$1: CONNECTOR_BOARD_OUTLINE
