NVSL/Quadcopters/Controller/Eagle/Projects/Controller/controller_v6.brd

## EAGLE design Controller/Eagle/Projects/Controller/controller_v6.brd (2015-02-03)

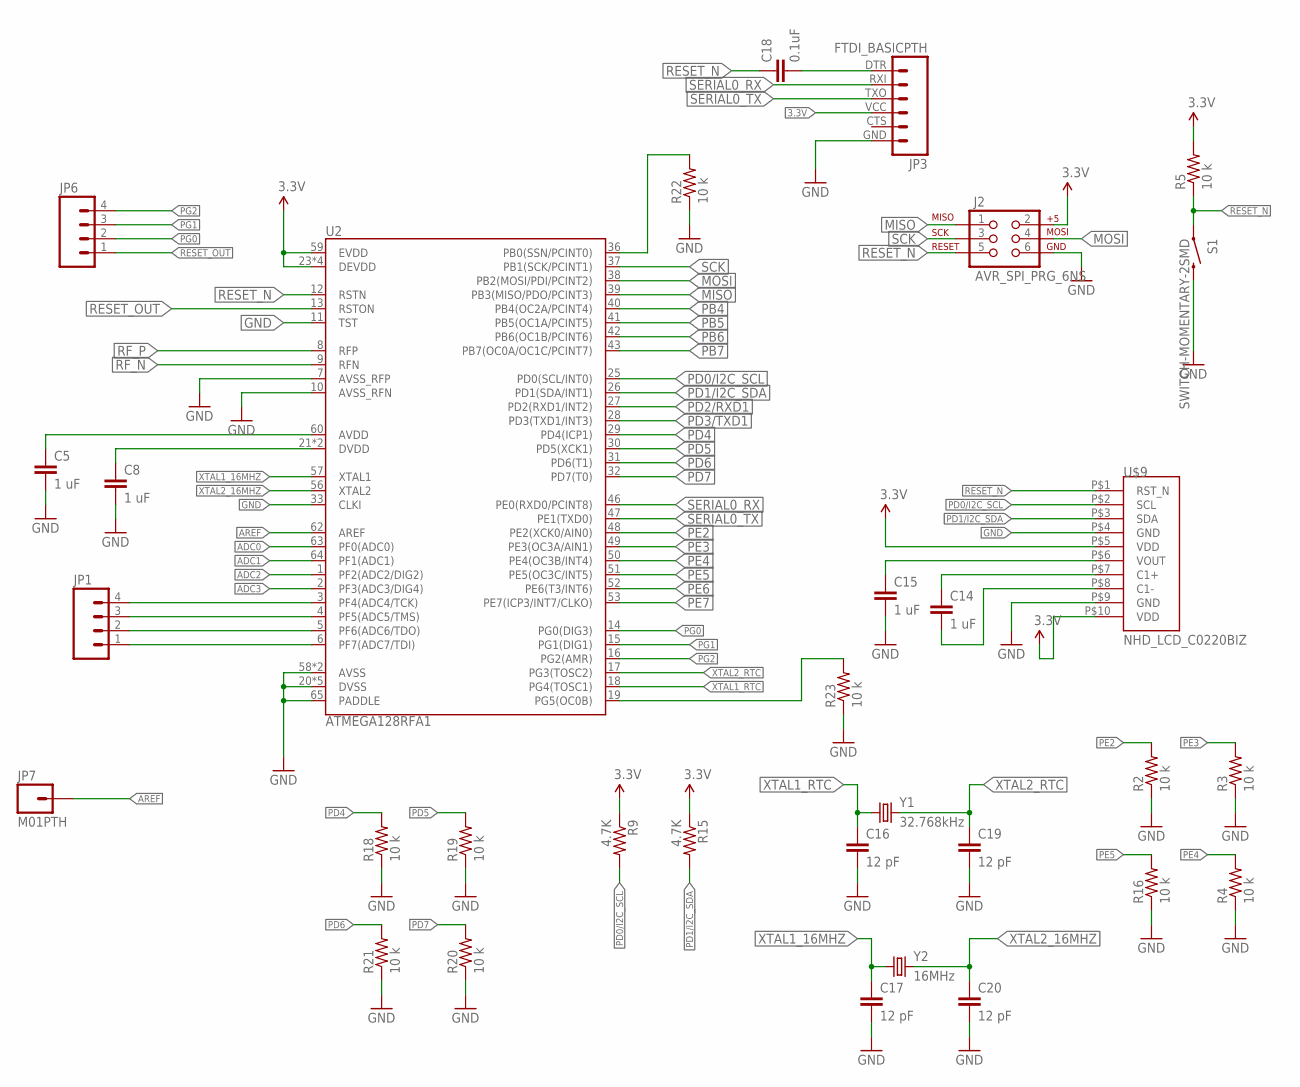
[picture p70: schematic controller_v6.sch, sheet 1]

Parts:
C5, C8, C14, C15: 1 uF; 0805
C16, C17, C19, C20: 12 pF; 0805
C18: 0.1uF; 0805
J2: AVR_SPI_PRG_6NS; 2X3-NS
JP1, JP6: M04PTH; 1X04
JP3: FTDI_BASICPTH; FTDI_BASIC
JP7: M01PTH; 1X01
R2, R3, R4, R5, R16, R18, R19, R20, R21, R22, R23: 10 k; 0805
R9, R15: 4.7K; 0805
S1: SWITCH-MOMENTARY-2SMD; TACTILE_SWITCH_SMD
U2: ATMEGA128RFA1; QFN-64
U$9: NHD_LCD_C0220BIZ; 1X08-2MMPTH-LCD
Y1: 32.768kHz; CRYSTAL-32KHZ-SMD
Y2: 16MHz; CRYSTAL-SMD-5X3

Connections:
3.3V: J2.2, JP3.VCC (4), R5.2, R9.1, R15.1, U2.23 (DEVDD), U2.34 (DEVDD), U2.44 (DEVDD), U2.54 (DEVDD), U2.59 (EVDD), U$9.P$5 (VDD), U$9.P$10 (VDD); also elsewhere on the board
ADC0: U2.63 (PF0(ADC0)); also elsewhere on the board
ADC1: U2.64 (PF1(ADC1)); also elsewhere on the board
ADC2: U2.1 (PF2(ADC2/DIG2)); also elsewhere on the board
ADC3: U2.2 (PF3(ADC3/DIG4)); also elsewhere on the board
ADC4: JP1.4, U2.3 (PF4(ADC4/TCK))
ADC5: JP1.3, U2.4 (PF5(ADC5/TMS))
ADC6: JP1.2, U2.5 (PF6(ADC6/TDO))
ADC7: JP1.1, U2.6 (PF7(ADC7/TDI))
AREF: JP7.1, U2.62 (AREF)
GND: C5.2, C8.2, C15.2, C16.2, C17.2, C19.2, C20.2, J2.6, JP3.GND (6), R2.1, R3.1, R4.1, R16.1, R18.1, R19.1, R20.1, R21.1, R22.1, R23.1, S1.3 (2), U2.7 (AVSS_RFP), U2.10 (AVSS_RFN), U2.11 (TST), U2.20 (DVSS), U2.24 (DVSS), U2.33 (CLKI), U2.35 (DVSS), U2.45 (DVSS), U2.55 (DVSS), U2.58 (AVSS), U2.61 (AVSS), U2.65 (PADDLE), U$9.P$4 (GND), U$9.P$9 (GND); also elsewhere on the board
MISO: J2.1, U2.39 (PB3(MISO/PDO/PCINT3))
MOSI: J2.4, U2.38 (PB2(MOSI/PDI/PCINT2))
unnamed: C18.2, JP3.DTR (1)
unnamed: C14.1, U$9.P$7 (C1+)
unnamed: C5.1, U2.60 (AVDD)
unnamed: C8.1, U2.21 (DVDD), U2.22 (DVDD)
unnamed: C14.2, U$9.P$8 (C1-)
PB0: R22.2, U2.36 (PB0(SSN/PCINT0))
PB1: R23.2, U2.19 (PG5(OC0B))
PB4: U2.40 (PB4(OC2A/PCINT4)); also elsewhere on the board
PB5: U2.41 (PB5(OC1A/PCINT5)); also elsewhere on the board
PB6: U2.42 (PB6(OC1B/PCINT6)); also elsewhere on the board
PB7: U2.43 (PB7(OC0A/OC1C/PCINT7)); also elsewhere on the board
PD0/I2C_SCL: R9.2, U2.25 (PD0(SCL/INT0)), U$9.P$2 (SCL)
PD1/I2C_SDA: R15.2, U2.26 (PD1(SDA/INT1)), U$9.P$3 (SDA)
PD2/RXD1: U2.27 (PD2(RXD1/INT2)); also elsewhere on the board
PD3/TXD1: U2.28 (PD3(TXD1/INT3)); also elsewhere on the board
PD4: R18.2, U2.29 (PD4(ICP1))
PD5: R19.2, U2.30 (PD5(XCK1))
PD6: R21.2, U2.31 (PD6(T1))
PD7: R20.2, U2.32 (PD7(T0))
PE2: R2.2, U2.48 (PE2(XCK0/AIN0))
PE3: R3.2, U2.49 (PE3(OC3A/AIN1))
PE4: R4.2, U2.50 (PE4(OC3B/INT4))
PE5: R16.2, U2.51 (PE5(OC3C/INT5))
PE6: U2.52 (PE6(T3/INT6)); also elsewhere on the board
PE7: U2.53 (PE7(ICP3/INT7/CLKO)); also elsewhere on the board
PG0: JP6.2, U2.14 (PG0(DIG3))
PG1: JP6.3, U2.15 (PG1(DIG1))
PG2: JP6.4, U2.16 (PG2(AMR))
RESET_N: C18.1, J2.5, R5.1, S1.1, U2.12 (RSTN), U$9.P$1 (RST_N)
RESET_OUT: JP6.1, U2.13 (RSTON)
RF_N: U2.9 (RFN); also elsewhere on the board
RF_P: U2.8 (RFP); also elsewhere on the board
SCK: J2.3, U2.37 (PB1(SCK/PCINT1))
SERIAL0_RX: JP3.RXI (2), U2.46 (PE0(RXD0/PCINT8))
SERIAL0_TX: JP3.TXO (3), U2.47 (PE1(TXD0))
VOUT: C15.1, U$9.P$6 (VOUT)
XTAL1_16MHZ: C17.1, U2.57 (XTAL1), Y2.1
XTAL1_RTC: C16.1, U2.18 (PG4(TOSC1)), Y1.X1 (1)
XTAL2_16MHZ: C20.1, U2.56 (XTAL2), Y2.3 (2)
XTAL2_RTC: C19.1, U2.17 (PG3(TOSC2)), Y1.X2 (2)

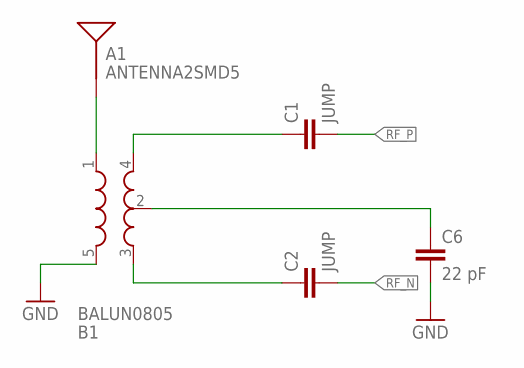
[picture p71: schematic controller_v6.sch, sheet 2]

Parts:
A1: ANTENNA2SMD5; ANTENNA-CHIP5
B1: BALUN0805; BALUN
C1, C2: JUMP; 0805
C6: 22 pF; 0805

Connections:
GND: B1.5 (GND), C6.2; also elsewhere on the board
unnamed: B1.4 (OUT1), C1.1
unnamed: B1.3 (OUT2), C2.1
unnamed: B1.2 (GND), C6.1
unnamed: A1.FEED, B1.1 (IN)
RF_N: C2.2; also elsewhere on the board
RF_P: C1.2; also elsewhere on the board

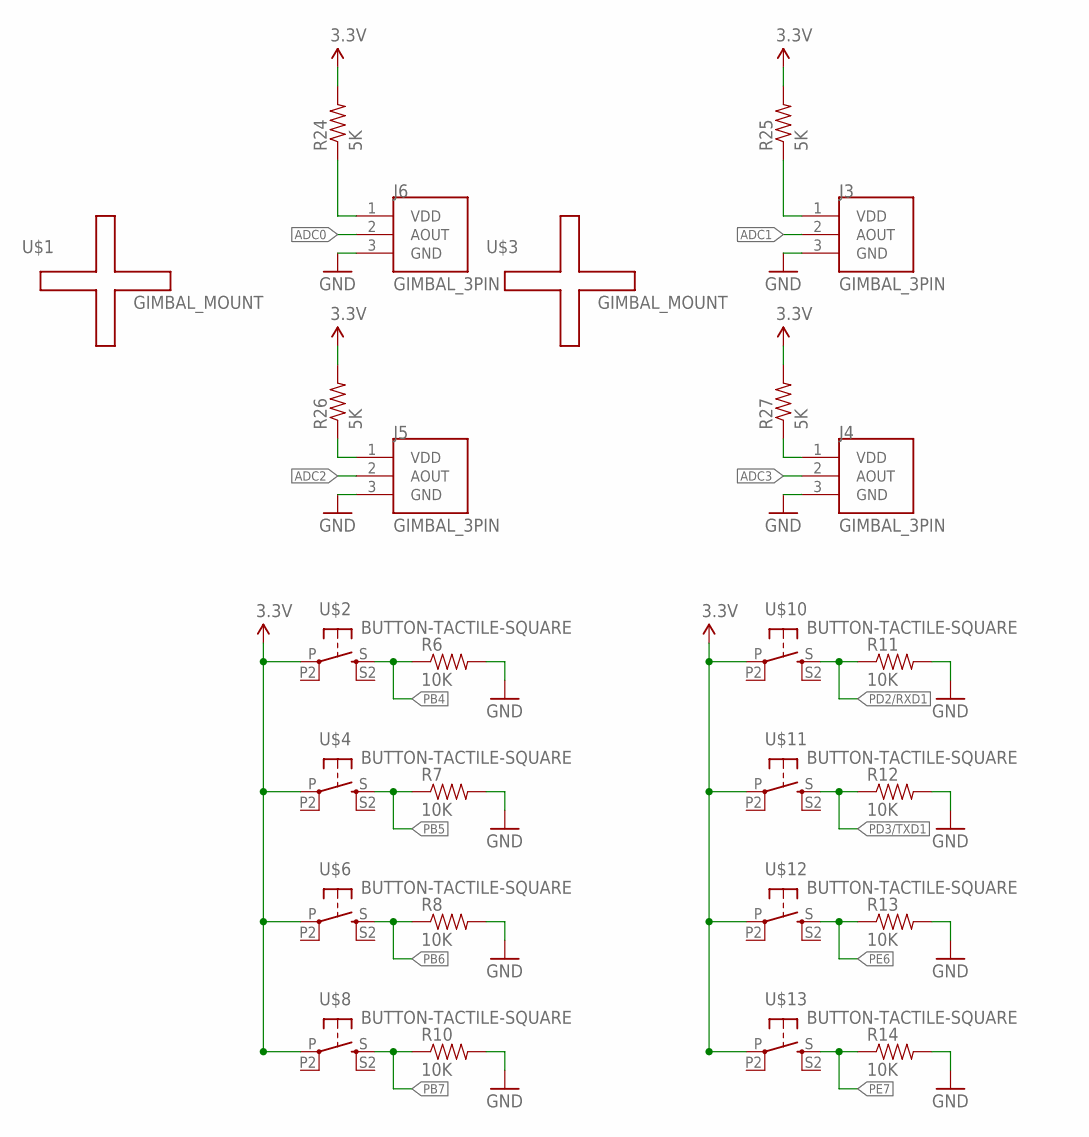
[picture p72: schematic controller_v6.sch, sheet 3]

Parts:
J3, J4, J5, J6: GIMBAL_3PIN; JST-3-PTH
R6, R7, R8, R10, R11, R12, R13, R14: 10K; 0805
R24, R25, R26, R27: 5K; 0805
U$1, U$3: GIMBAL_MOUNT; GIMBAL_FOOTPRINT
U$2, U$4, U$6, U$8, U$10, U$11, U$12, U$13: BUTTON-TACTILE-SQUARE; BUTTON-TACTILE-SQUARE-ADAFRUIT1010

Connections:
3.3V: R24.2, R25.2, R26.2, R27.2, U$2.P, U$4.P, U$6.P, U$8.P, U$10.P, U$11.P, U$12.P, U$13.P; also elsewhere on the board
ADC0: J6.2 (AOUT); also elsewhere on the board
ADC1: J3.2 (AOUT); also elsewhere on the board
ADC2: J5.2 (AOUT); also elsewhere on the board
ADC3: J4.2 (AOUT); also elsewhere on the board
GND: J3.3 (GND), J4.3 (GND), J5.3 (GND), J6.3 (GND), R6.2, R7.2, R8.2, R10.2, R11.2, R12.2, R13.2, R14.2; also elsewhere on the board
unnamed: J6.1 (VDD), R24.1
unnamed: J3.1 (VDD), R25.1
unnamed: J5.1 (VDD), R26.1
unnamed: J4.1 (VDD), R27.1
PB4: R6.1, U$2.S; also elsewhere on the board
PB5: R7.1, U$4.S; also elsewhere on the board
PB6: R8.1, U$6.S; also elsewhere on the board
PB7: R10.1, U$8.S; also elsewhere on the board
PD2/RXD1: R11.1, U$10.S; also elsewhere on the board
PD3/TXD1: R12.1, U$11.S; also elsewhere on the board
PE6: R13.1, U$12.S; also elsewhere on the board
PE7: R14.1, U$13.S; also elsewhere on the board

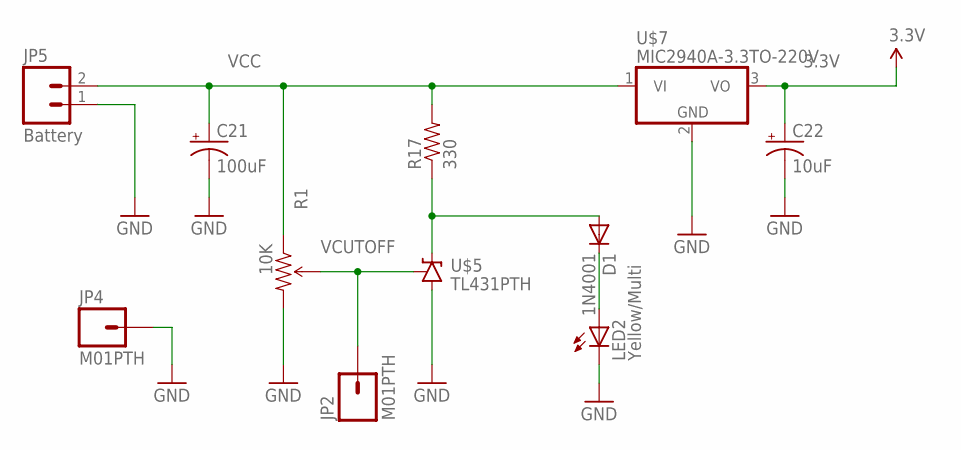
[picture p73: schematic controller_v6.sch, sheet 4]

Parts:
C21: 100uF; E3,5-8
C22: 10uF; E2,5-5
D1: 1N4001; DO41-10
JP2, JP4: M01PTH; 1X01
JP5: Battery; 1X02
LED2: Yellow/Multi; LED5MM
R1: 10K; 3386U
R17: 330; AXIAL-0.3
U$5: TL431PTH; TO-92
U$7: MIC2940A-3.3TO-220V; TO-220V

Connections:
3.3V: C22.+, U$7.3 (VO); also elsewhere on the board
GND: C21.-, C22.-, JP4.1, JP5.1, LED2.K (C), R1.3 (CW), U$5.2 (A), U$7.2 (GND); also elsewhere on the board
unnamed: D1.A, R17.P$1 (1), U$5.3 (C)
unnamed: D1.C, LED2.A
VCC: C21.+, JP5.2, R1.1 (CCW), R17.P$2 (2), U$7.1 (VI)
VCUTOFF: JP2.1, R1.2 (WIPER), U$5.1 (R)

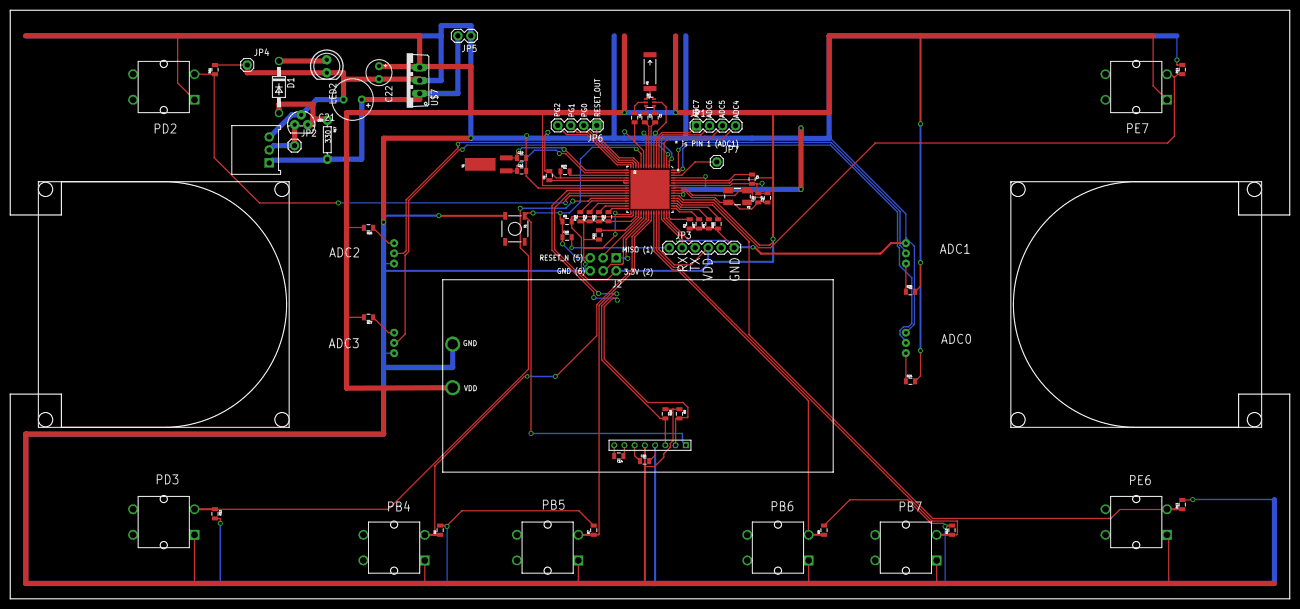
[picture p74: board controller_v6.brd from above]

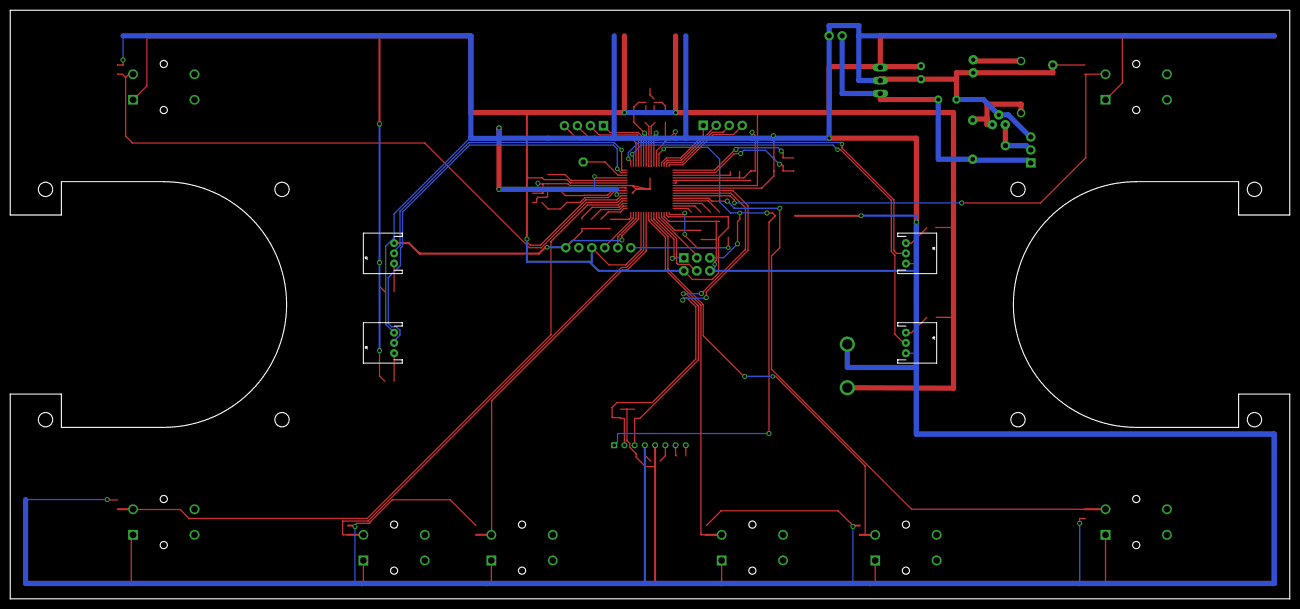
[picture p75: board controller_v6.brd from below]

Board: 2 copper layers, 250.0 x 115.0 mm, 74 parts (4 on the bottom side), 65 nets.
