NVSL/Quadcopters/Power/stripped_th/power_supply_stripped_th.brd

## EAGLE design Power/stripped_th/power_supply_stripped_th.brd (2014-12-01)

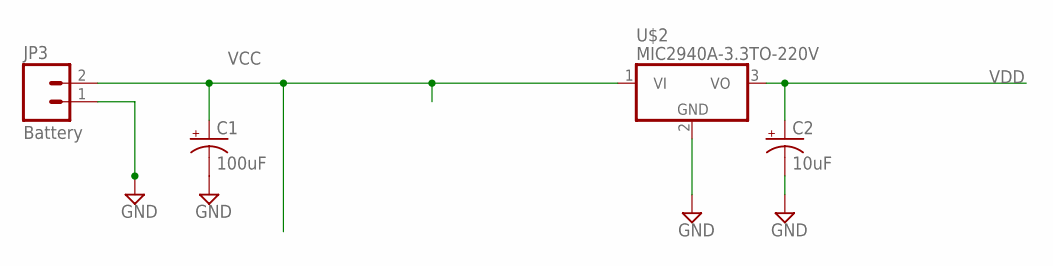
[picture p76: schematic power_supply_stripped_th.sch]

Parts:
C1: 100uF; E3,5-8
C2: 10uF; E2,5-5
JP3: Battery; 1X02
U$2: MIC2940A-3.3TO-220V; TO-220V

Connections:
GND: C1.-, C2.-, JP3.1, U$2.2 (GND)
VCC: C1.+, JP3.2, U$2.1 (VI)
VDD: C2.+, U$2.3 (VO)

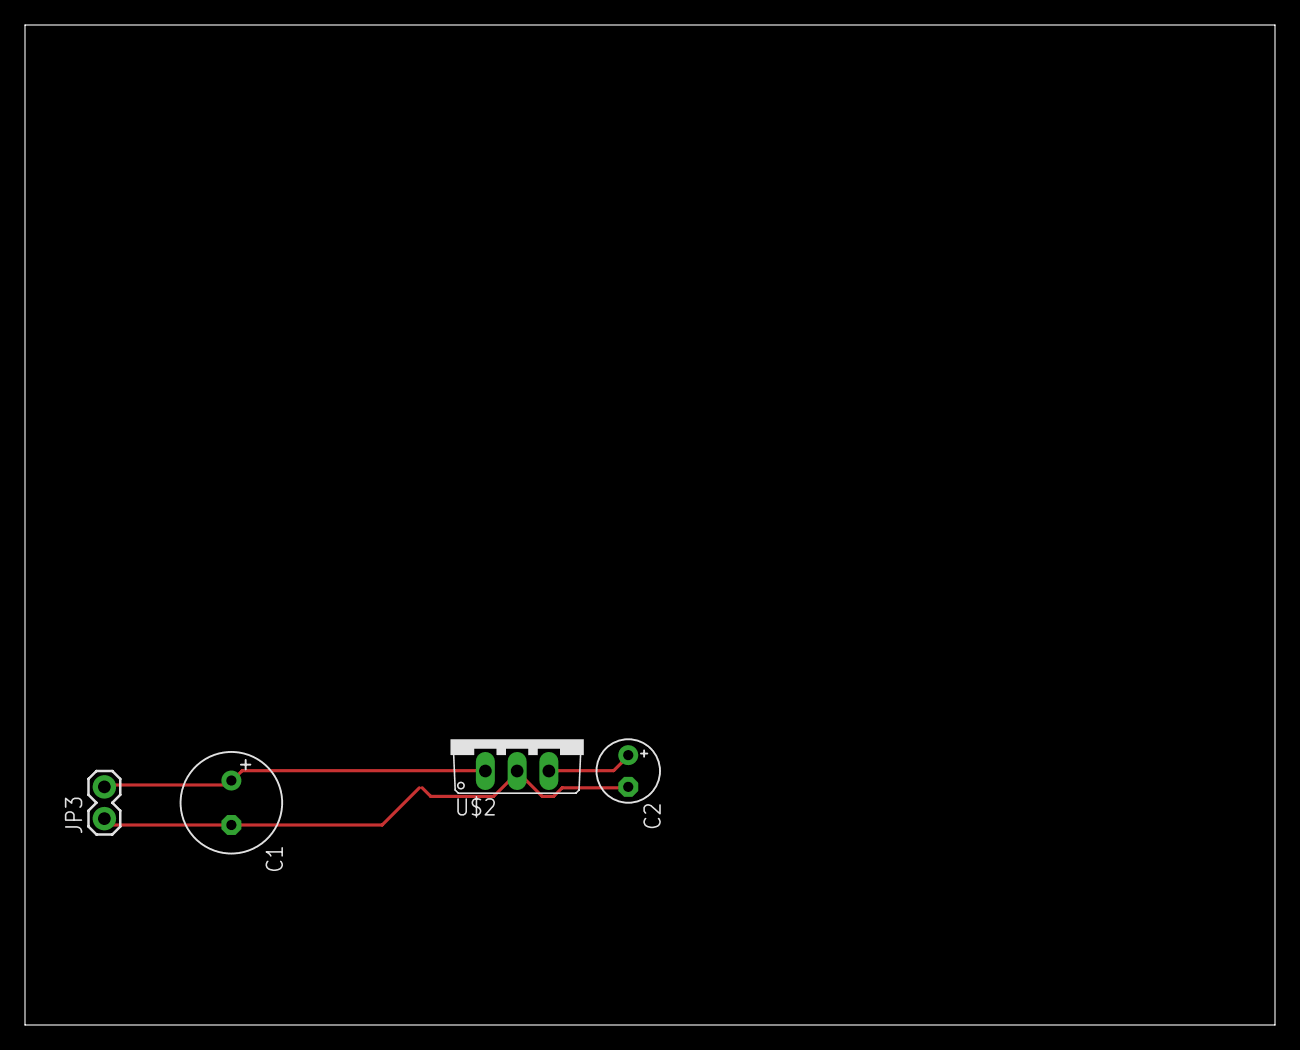
[picture p77: board power_supply_stripped_th.brd from above]

Board: 2 copper layers, 100.0 x 80.0 mm, 4 parts (0 on the bottom side), 3 nets.
