NVSL/Quadcopters/Motor/motorboardsurface.brd

## EAGLE design Motor/motorboardsurface.brd (2014-11-19)

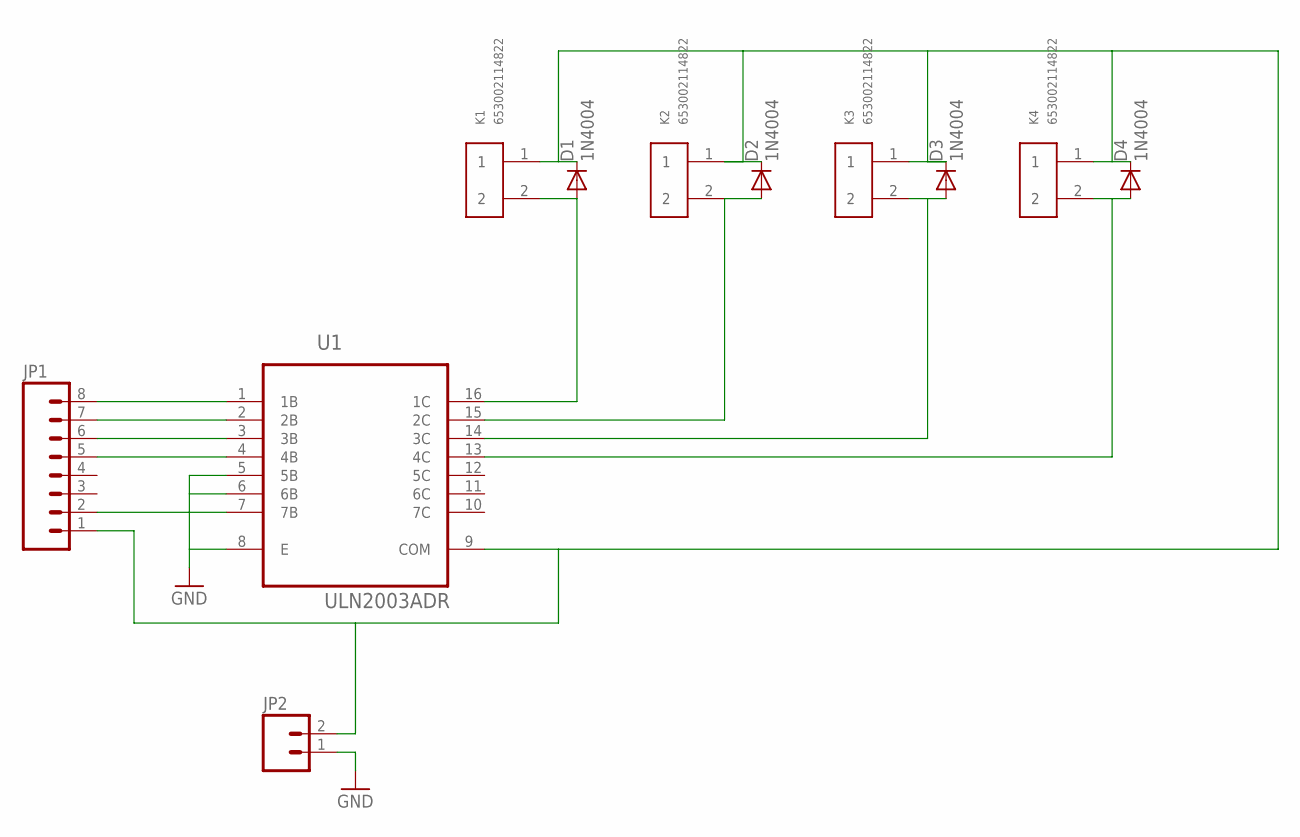
[picture p78: schematic motorboardsurface.sch]

Parts:
D1, D2, D3, D4: 1N4004; DO41-10; MPN 1N4004
JP1: M08NO_SILK_FEMALE_PTH; 1X08_NO_SILK
JP2: M02LOCK_LONGPADS; 1X02_LOCK_LONGPADS
K1, K2, K3, K4: 653002114822
U1: ULN2003ADR; SOIC127P600X175-16N

Connections:
GND: JP1.2, JP2.1, U1.5 (5B), U1.6 (6B), U1.7 (7B), U1.8 (E)
unnamed: D1.C, D2.C, D3.C, D4.C, JP1.1, JP2.2, K1.1, K2.1, K3.1, K4.1, U1.9 (COM)
unnamed: JP1.8, U1.1 (1B)
unnamed: JP1.7, U1.2 (2B)
unnamed: JP1.6, U1.3 (3B)
unnamed: JP1.5, U1.4 (4B)
unnamed: D1.A, K1.2, U1.16 (1C)
unnamed: D2.A, K2.2, U1.15 (2C)
unnamed: D3.A, K3.2, U1.14 (3C)
unnamed: D4.A, K4.2, U1.13 (4C)

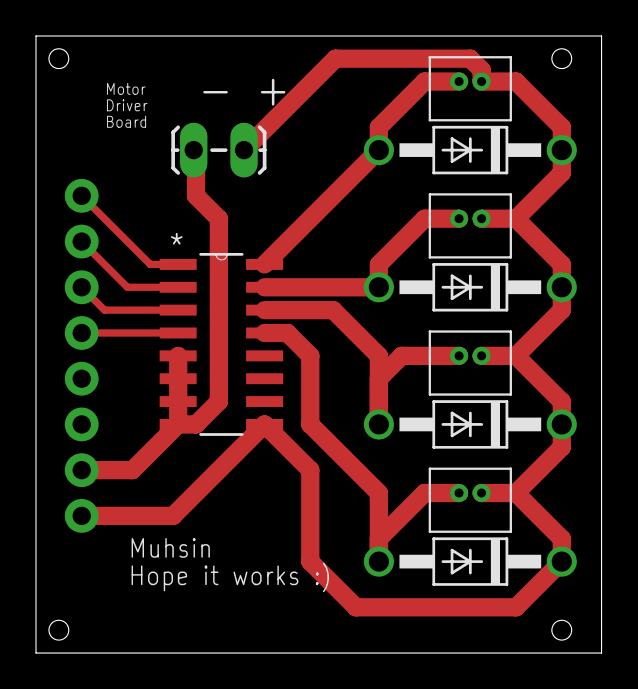
[picture p79: board motorboardsurface.brd from above]

Board: 2 copper layers, 31.4 x 34.3 mm, 11 parts (0 on the bottom side), 10 nets.
