NVSL/Quadcopters/IMU/board.brd

## EAGLE design IMU/board.brd (2014-11-15)

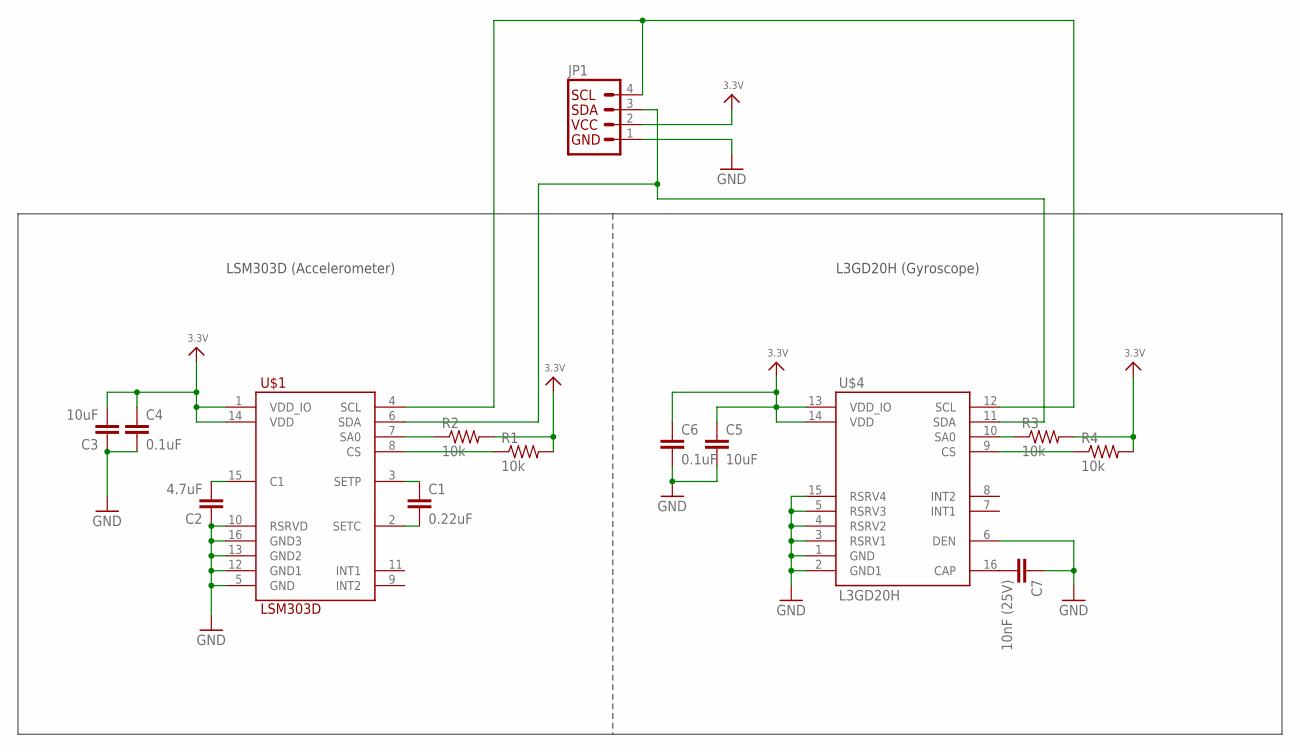
[picture p80: schematic board.sch]

Parts:
C1: 0.22uF; 0805
C2: 4.7uF; 0805
C3, C5: 10uF; 0805
C4, C6: 0.1uF; 0805
C7: 10nF (25V); 0805
JP1: I2C_STANDARD; 1X04
R1, R2, R3, R4: 10k; 0805
U$1: LSM303D; LGA16_3X3MM
U$4: L3GD20H; LGA16_3X3MM

Connections:
3.3V: C3.2, C4.1, C5.1, C6.1, JP1.2, R1.2, R2.2, R3.2, R4.2, U$1.1 (VDD_IO), U$1.14 (VDD), U$4.13 (VDD_IO), U$4.14 (VDD)
GND: C2.1, C3.1, C4.2, C5.2, C6.2, C7.1, JP1.1, U$1.5 (GND), U$1.10 (RSRVD), U$1.12 (GND1), U$1.13 (GND2), U$1.16 (GND3), U$4.1 (GND), U$4.2 (GND1), U$4.3 (RSRV1), U$4.4 (RSRV2), U$4.5 (RSRV3), U$4.6 (DEN), U$4.15 (RSRV4)
unnamed: C1.1, U$1.3 (SETP)
unnamed: C1.2, U$1.2 (SETC)
unnamed: R1.1, U$1.8 (CS)
unnamed: R2.1, U$1.7 (SA0)
unnamed: C2.2, U$1.15 (C1)
unnamed: R3.1, U$4.10 (SA0)
unnamed: R4.1, U$4.9 (CS)
unnamed: C7.2, U$4.16 (CAP)
unnamed: JP1.4, U$1.4 (SCL), U$4.12 (SCL)
unnamed: JP1.3, U$1.6 (SDA), U$4.11 (SDA)

Notes on the sheet:
LSM303D (Accelerometer)
L3GD20H (Gyroscope)
