NVSL/Quadcopters/IMU/board.brd

## EAGLE design IMU/board.brd (continued)

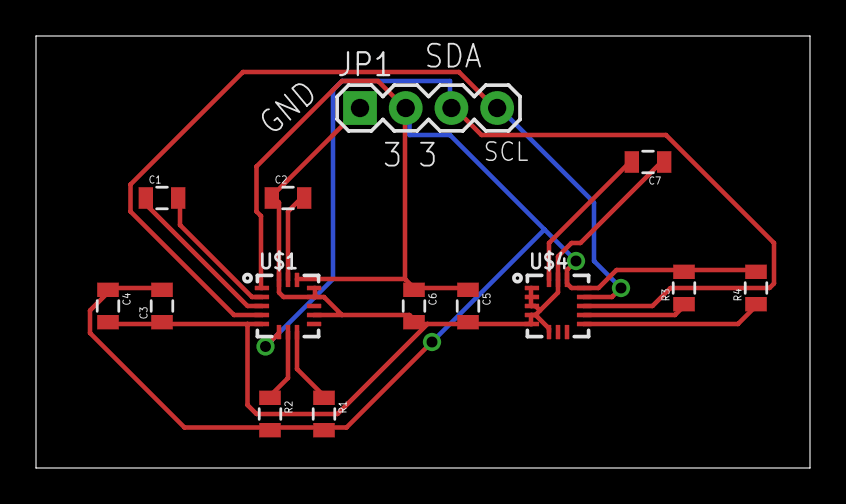
[picture p81: board board.brd from above]

Board: 2 copper layers, 43.0 x 24.0 mm, 14 parts (0 on the bottom side), 12 nets.
