NVSL/Quadcopters/Power/power_supply.brd

## EAGLE design Power/power_supply.brd (2014-11-12)

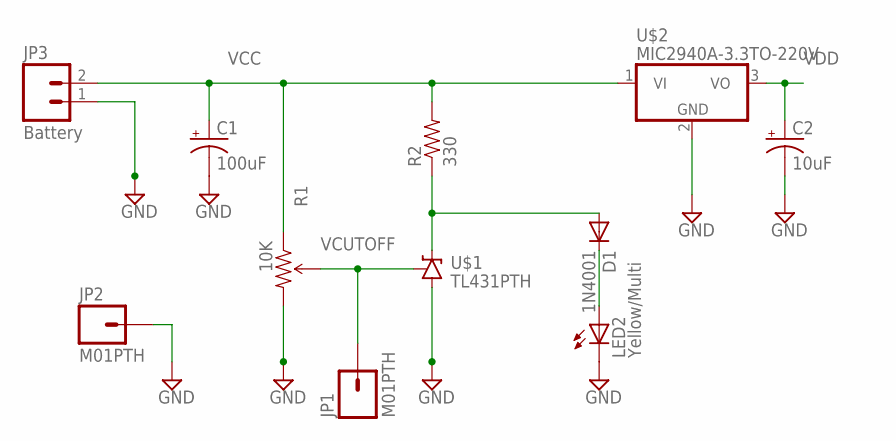
[picture p82: schematic power_supply.sch]

Parts:
C1: 100uF; E3,5-8
C2: 10uF; E2,5-5
D1: 1N4001; DO41-10
JP1, JP2: M01PTH; 1X01
JP3: Battery; 1X02
LED2: Yellow/Multi; LED5MM
R1: 10K; 3386U
R2: 330; AXIAL-0.3
U$1: TL431PTH; TO-92
U$2: MIC2940A-3.3TO-220V; TO-220V

Connections:
GND: C1.-, C2.-, JP2.1, JP3.1, LED2.K (C), R1.3 (CW), U$1.2 (A), U$2.2 (GND)
unnamed: D1.C, LED2.A
unnamed: D1.A, R2.P$1 (1), U$1.3 (C)
VCC: C1.+, JP3.2, R1.1 (CCW), R2.P$2 (2), U$2.1 (VI)
VCUTOFF: JP1.1, R1.2 (WIPER), U$1.1 (R)
VDD: C2.+, U$2.3 (VO)

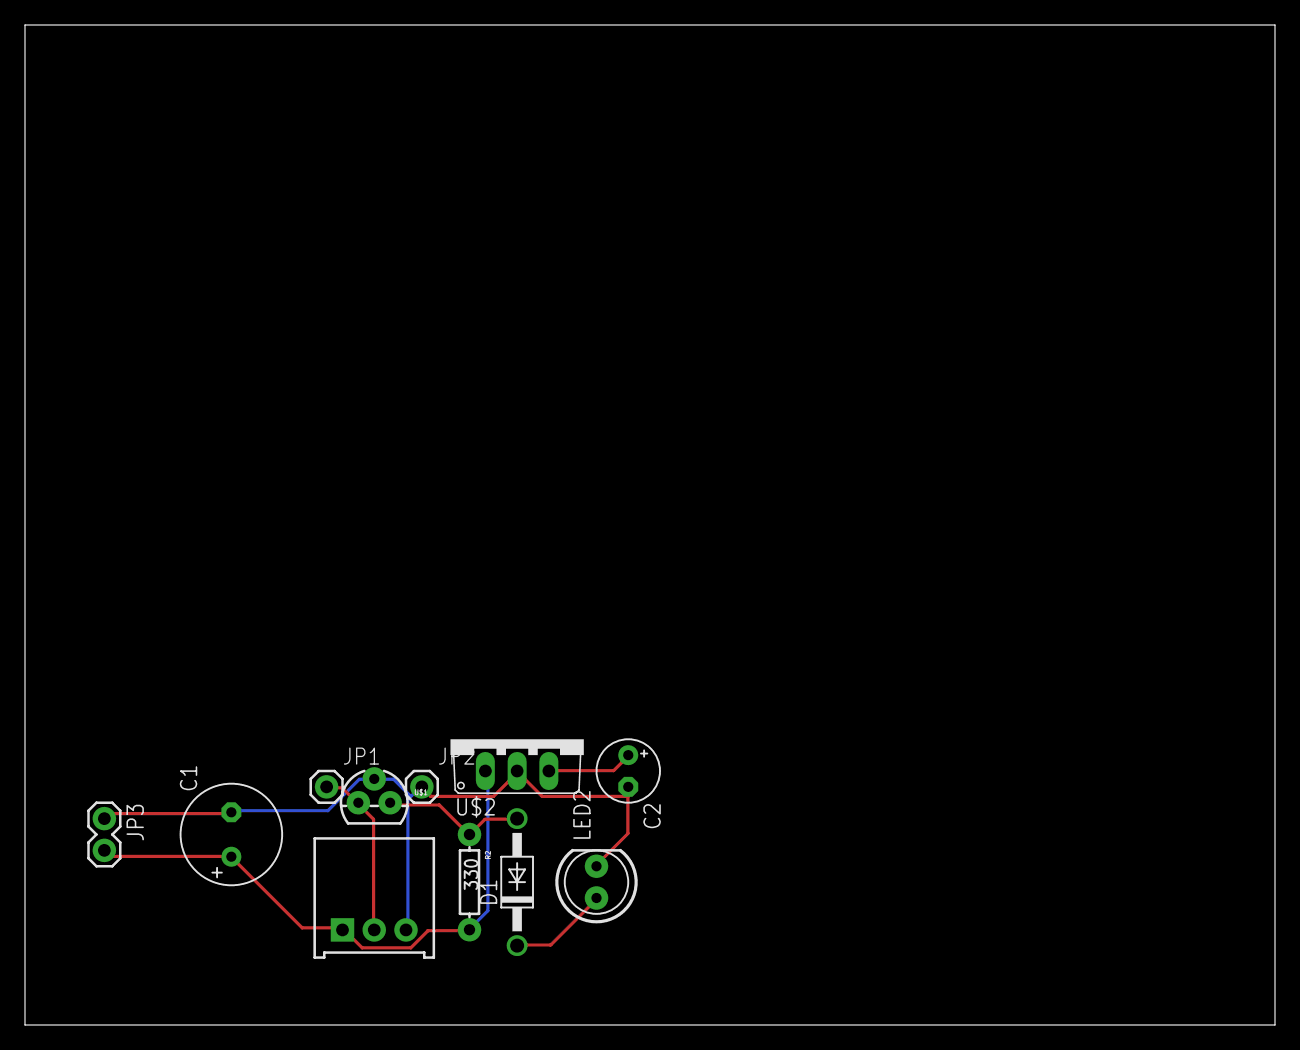
[picture p83: board power_supply.brd from above]

Board: 2 copper layers, 100.0 x 80.0 mm, 11 parts (0 on the bottom side), 6 nets.
