NVSL/Quadcopters/Controller/Eagle/Projects/Controller/Gimbal_test.brd

## EAGLE design Controller/Eagle/Projects/Controller/Gimbal_test.brd (2014-10-31)

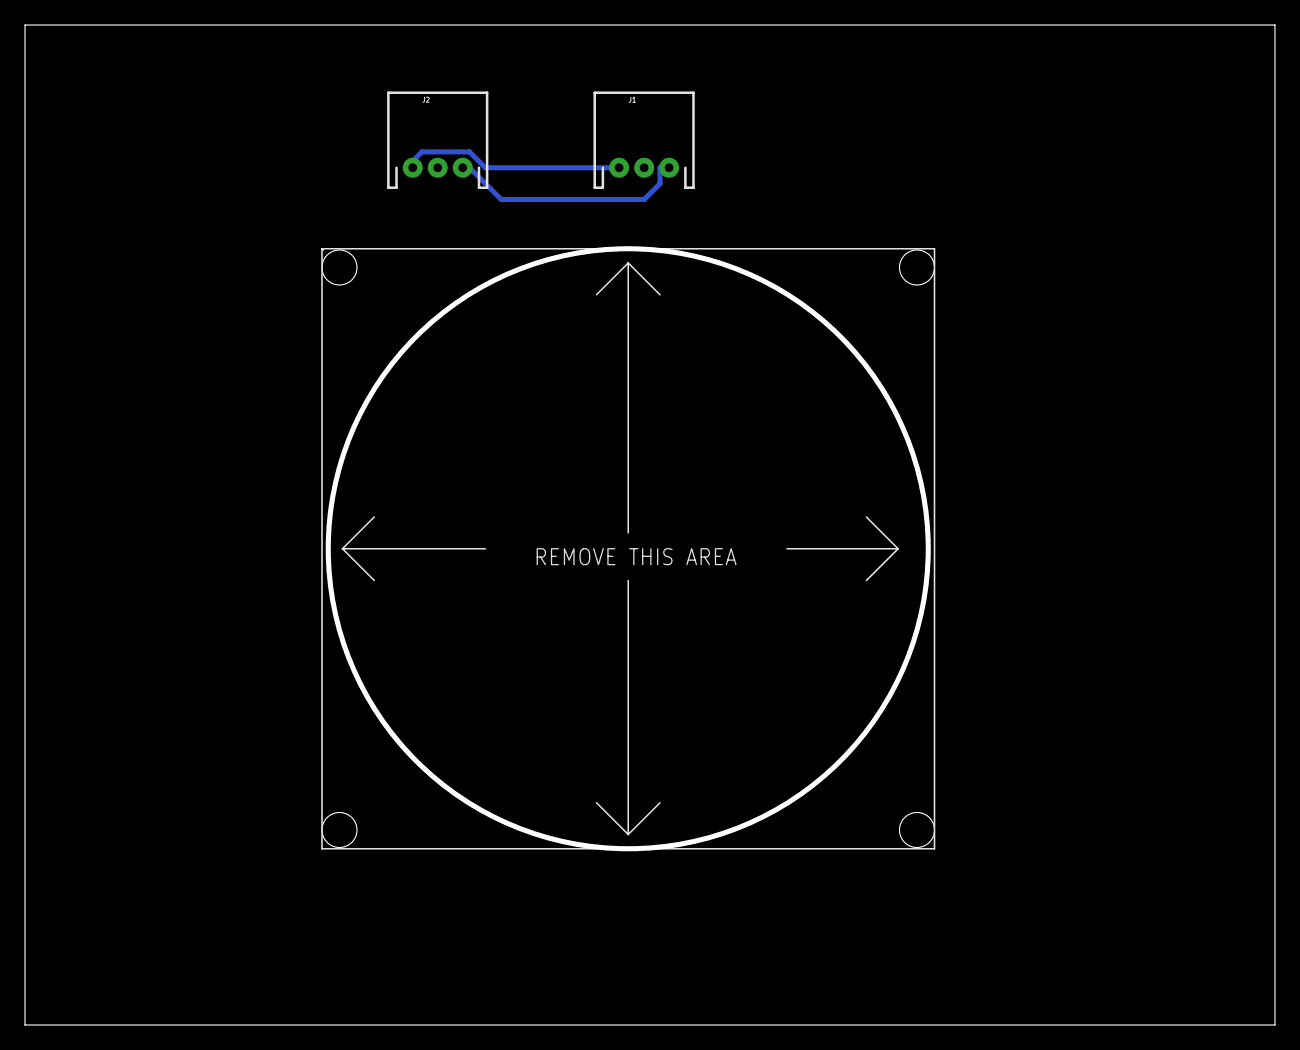
[picture p84: board Gimbal_test.brd from above]

Board: 2 copper layers, 100.0 x 80.0 mm, 3 parts (0 on the bottom side), 2 nets.

Parts:
J1, J2: GIMBAL_3PIN; JST-3-PTH
U$1: GIMBAL_MOUNT; GIMBAL_FOOTPRINT

Connections:
GND: J1.3, J2.3
VDD: J1.1, J2.1
