NVSL/Quadcopters/Controller/Eagle/Projects/Controller/controller_v1.brd

## EAGLE design Controller/Eagle/Projects/Controller/controller_v1.brd (2014-10-31, an earlier design)

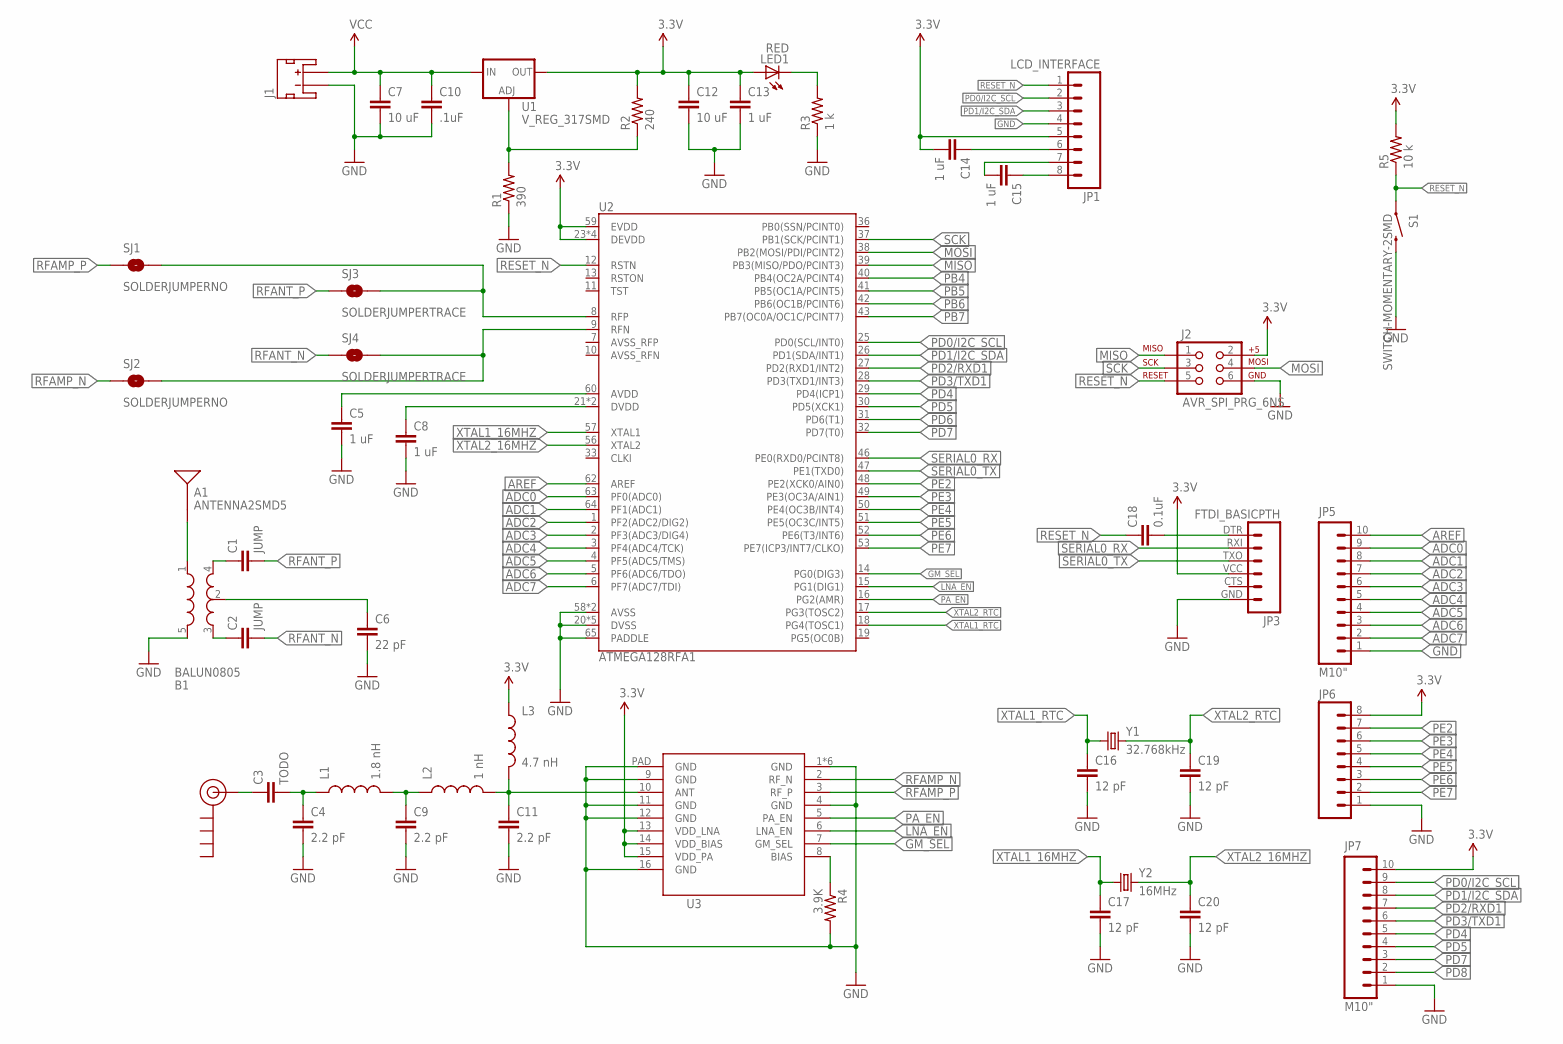
[picture p85: schematic controller_v1.sch]

Parts:
A1: ANTENNA2SMD5; ANTENNA-CHIP5
B1: BALUN0805; BALUN
C1, C2: JUMP; 0805
C3: TODO; 0805
C4, C9, C11: 2.2 pF; 0805
C5, C8, C13, C14, C15: 1 uF; 0805
C6: 22 pF; 0805
C7, C12: 10 uF; 0805
C10: .1uF; 0805
C16, C17, C19, C20: 12 pF; 0805
C18: 0.1uF; 0805
J1: BATT; JST-2-SMD
J2: AVR_SPI_PRG_6NS; 2X3-NS
J$1: SMA_EDGE; SMA-EDGE
JP1: LCD_INTERFACE; 1X08
JP3: FTDI_BASICPTH; FTDI_BASIC
JP5, JP7: M10"; 1X10
JP6: M081X08; 1X08
L1: 1.8 nH; 0805
L2: 1 nH; 0805
L3: 4.7 nH; 0805
LED1: RED; LED-0603
R1: 390; 0805
R2: 240; 0805
R3: 1 k; 0805
R4: 3.9K; 0805
R5: 10 k; 0805
S1: SWITCH-MOMENTARY-2SMD; TACTILE_SWITCH_SMD
SJ1, SJ2: SOLDERJUMPERNO; SJ_2S-NO
SJ3, SJ4: SOLDERJUMPERTRACE; SJ_2S-TRACE
U1: V_REG_317SMD; SOT223
U2: ATMEGA128RFA1; QFN-64
U3: RF_AMPLIFIER; QFN65P400X400X100-17N
Y1: 32.768kHz; CRYSTAL-32KHZ-SMD
Y2: 16MHz; CRYSTAL-SMD-5X3

Connections:
3.3V: C12.1, C13.1, C14.2, J2.2, JP1.5, JP3.VCC (4), JP6.8, JP7.10, L3.1, LED1.A, R2.2, R5.2, U1.2 (OUT), U2.23 (DEVDD), U2.34 (DEVDD), U2.44 (DEVDD), U2.54 (DEVDD), U2.59 (EVDD), U3.13 (VDD_LNA), U3.14 (VDD_BIAS), U3.15 (VDD_PA)
ADC0: JP5.9, U2.63 (PF0(ADC0))
ADC1: JP5.8, U2.64 (PF1(ADC1))
ADC2: JP5.7, U2.1 (PF2(ADC2/DIG2))
ADC3: JP5.6, U2.2 (PF3(ADC3/DIG4))
ADC4: JP5.5, U2.3 (PF4(ADC4/TCK))
ADC5: JP5.4, U2.4 (PF5(ADC5/TMS))
ADC6: JP5.3, U2.5 (PF6(ADC6/TDO))
ADC7: JP5.2, U2.6 (PF7(ADC7/TDI))
AREF: JP5.10, U2.62 (AREF)
GM_SEL: U2.14 (PG0(DIG3)), U3.7 (GM_SEL)
GND: B1.5 (GND), C4.2, C5.2, C6.2, C7.2, C8.2, C9.2, C10.2, C11.2, C12.2, C13.2, C16.2, C17.2, C19.2, C20.2, J1.1 (-), J2.6, JP1.4, JP3.GND (6), JP5.1, JP6.1, JP7.1, R1.1, R3.1, R4.2, S1.3 (2), U2.20 (DVSS), U2.24 (DVSS), U2.35 (DVSS), U2.45 (DVSS), U2.55 (DVSS), U2.58 (AVSS), U2.61 (AVSS), U2.65 (PADDLE), U3.1 (GND), U3.4 (GND), U3.9 (GND), U3.11 (GND), U3.12 (GND), U3.16 (GND), U3.P$1 (GND), U3.P$2 (GND), U3.P$3 (GND), U3.P$4 (GND), U3.P$5 (GND), U3.PAD (GND)
LNA_EN: U2.15 (PG1(DIG1)), U3.6 (LNA_EN)
MISO: J2.1, U2.39 (PB3(MISO/PDO/PCINT3))
MOSI: J2.4, U2.38 (PB2(MOSI/PDI/PCINT2))
unnamed: C9.1, L1.2, L2.1
unnamed: C18.2, JP3.DTR (1)
unnamed: C11.1, L2.2, L3.2, U3.10 (ANT)
unnamed: C3.2, C4.1, L1.1
unnamed: SJ1.2, SJ3.2, U2.8 (RFP)
unnamed: SJ2.2, SJ4.2, U2.9 (RFN)
unnamed: R4.1, U3.8 (BIAS)
unnamed: C3.1, J$1.SIG (SIGNAL)
unnamed: B1.4 (OUT1), C1.1
unnamed: B1.3 (OUT2), C2.1
unnamed: B1.2 (GND), C6.1
unnamed: A1.FEED, B1.1 (IN)
unnamed: R1.2, R2.1, U1.1 (ADJ)
unnamed: LED1.C, R3.2
unnamed: C5.1, U2.60 (AVDD)
unnamed: C8.1, U2.21 (DVDD), U2.22 (DVDD)
unnamed: C14.1, JP1.6
unnamed: C15.2, JP1.7
unnamed: C15.1, JP1.8
PA_EN: U2.16 (PG2(AMR)), U3.5 (PA_EN)
PB4: U2.40 (PB4(OC2A/PCINT4))
PB5: U2.41 (PB5(OC1A/PCINT5))
PB6: U2.42 (PB6(OC1B/PCINT6))
PB7: U2.43 (PB7(OC0A/OC1C/PCINT7))
PD0/I2C_SCL: JP1.2, JP7.9, U2.25 (PD0(SCL/INT0))
PD1/I2C_SDA: JP1.3, JP7.8, U2.26 (PD1(SDA/INT1))
PD2/RXD1: JP7.7, U2.27 (PD2(RXD1/INT2))
PD3/TXD1: JP7.6, U2.28 (PD3(TXD1/INT3))
PD4: JP7.5, U2.29 (PD4(ICP1))
PD5: JP7.4, U2.30 (PD5(XCK1))
PD6: U2.31 (PD6(T1))
PD7: JP7.3, U2.32 (PD7(T0))
PD8: JP7.2
PE2: JP6.7, U2.48 (PE2(XCK0/AIN0))
PE3: JP6.6, U2.49 (PE3(OC3A/AIN1))
PE4: JP6.5, U2.50 (PE4(OC3B/INT4))
PE5: JP6.4, U2.51 (PE5(OC3C/INT5))
PE6: JP6.3, U2.52 (PE6(T3/INT6))
PE7: JP6.2, U2.53 (PE7(ICP3/INT7/CLKO))
RESET_N: C18.1, J2.5, JP1.1, R5.1, S1.1, U2.12 (RSTN)
RFAMP_N: SJ2.1, U3.2 (RF_N)
RFAMP_P: SJ1.1, U3.3 (RF_P)
RFANT_N: C2.2, SJ4.1
RFANT_P: C1.2, SJ3.1
SCK: J2.3, U2.37 (PB1(SCK/PCINT1))
SERIAL0_RX: JP3.RXI (2), U2.46 (PE0(RXD0/PCINT8))
SERIAL0_TX: JP3.TXO (3), U2.47 (PE1(TXD0))
VCC: C7.1, C10.1, J1.2 (+), U1.3 (IN)
XTAL1_16MHZ: C17.1, U2.57 (XTAL1), Y2.1
XTAL1_RTC: C16.1, U2.18 (PG4(TOSC1)), Y1.X1 (1)
XTAL2_16MHZ: C20.1, U2.56 (XTAL2), Y2.3 (2)
XTAL2_RTC: C19.1, U2.17 (PG3(TOSC2)), Y1.X2 (2)

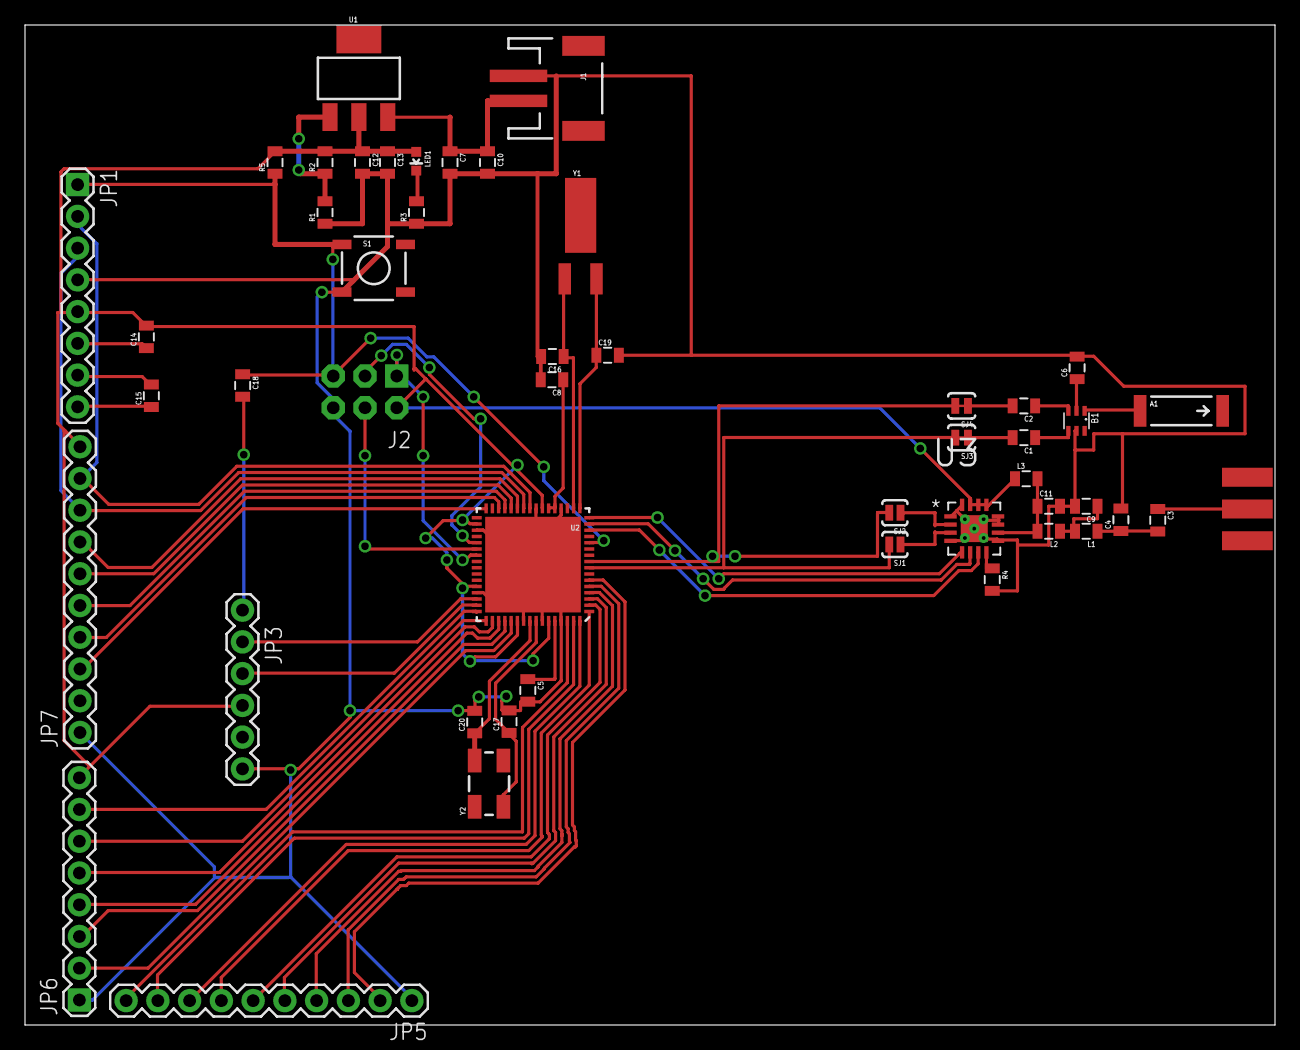
[picture p86: board controller_v1.brd from above]

Board: 2 copper layers, 100.0 x 80.0 mm, 49 parts (0 on the bottom side), 61 nets.
