NVSL/Quadcopters/Class/Demo Board/TinyDuino.brd

## EAGLE design Class/Demo Board/TinyDuino.brd (2014-10-19)

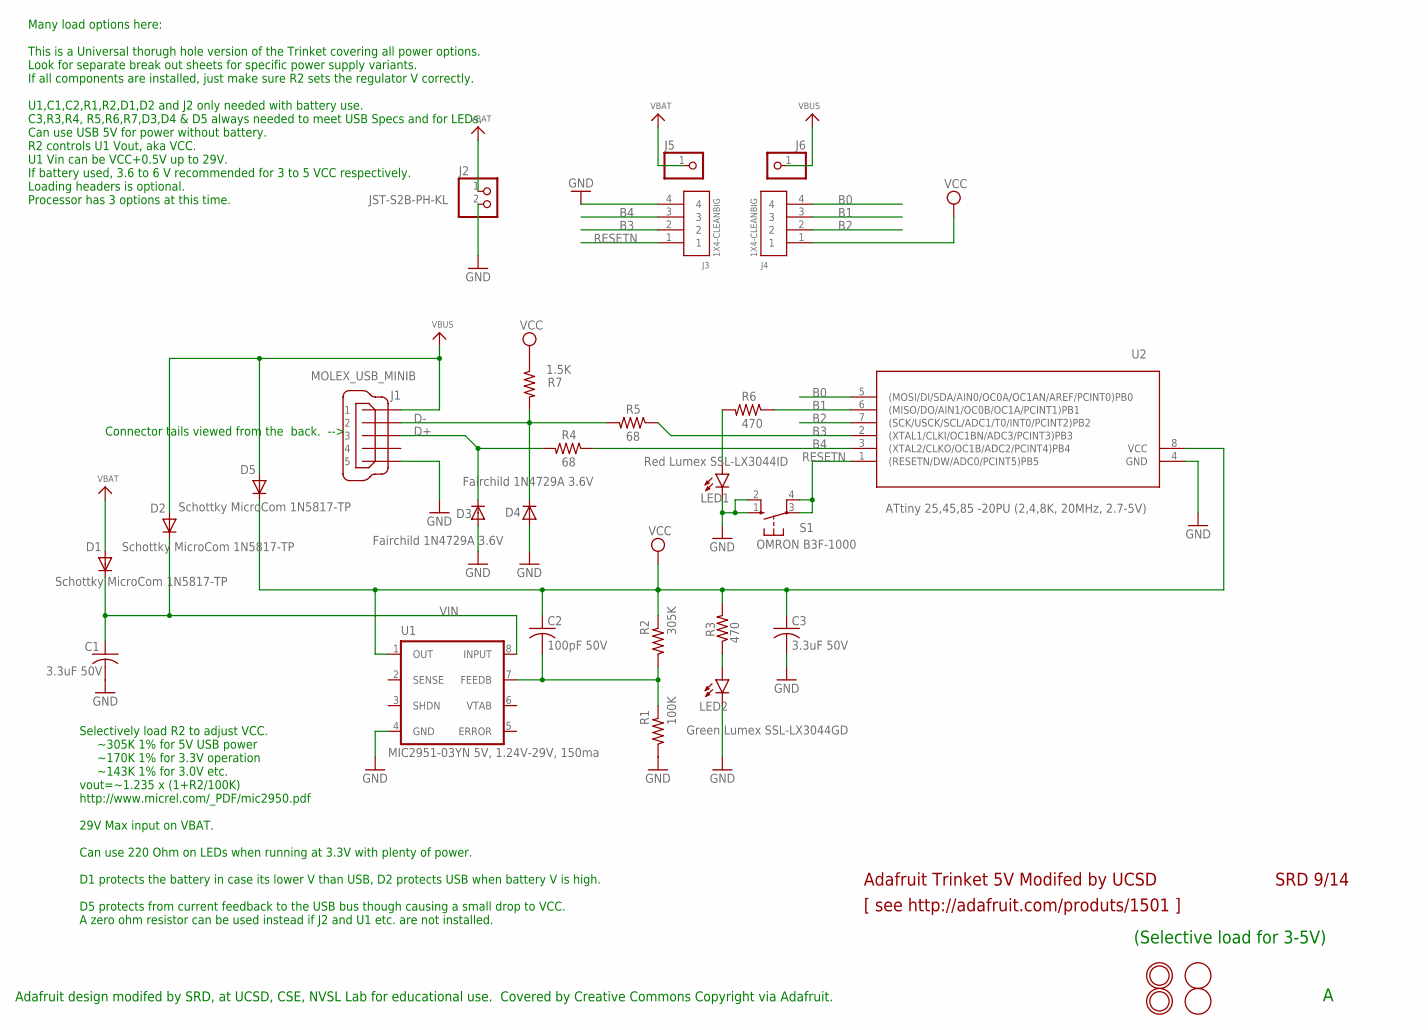
[picture p90: schematic TinyDuino.sch]

Parts:
C1, C3: 3.3uF 50V; C050-025X075; PARTNO FK20X7R1H335K
C2: 100pF 50V; C050-025X075; PARTNO FK28C0G1H101J
D1, D2, D5: Schottky MicroCom 1N5817-TP; DO41-7.6; PARTNO 1N5817-TP
D3, D4: Fairchild 1N4729A 3.6V; DO41-7.6; PARTNO 1N4729A
J1: MOLEX_USB_MINIB; 32005-601-ROUND; PARTNO 0548190519
J2: JST-S2B-PH-KL; JST_S2B_PH_KL; PARTNO JST_S2B_PH_KL
J3, J4: 1X4-CLEANBIG; 1X04-CLEANBIG
J5, J6: PINHD-1X1CB; 1X01-CLEANBIG
LED1: Red Lumex SSL-LX3044ID; LED3MM; PARTNO SSL-LX3044ID
LED2: Green Lumex SSL-LX3044GD; LED3MM; PARTNO SSL-LX3044GD
R1: 100K; 0204/7; PARTNO MFR-25FBF52-100K
R2: 305K; 0204/7; PARTNO MFR-25FBF52-301K
R3, R6: 470; 0204/7; PARTNO CFR-12JB-52-470R
R4, R5: 68; 0204/7; PARTNO CFR-12JB-52-68R
R7: 1.5K; 0204/7; PARTNO CFR-12JB-52-1K5
S1: OMRON B3F-1000; B3F-10XX; PARTNO B3F-1000
U1: MIC2951-03YN 5V, 1.24V-29V, 150ma; DIL08; PARTNO MIC2951-03YN
U2: ATtiny 25,45,85 -20PU (2,4,8K, 20MHz, 2.7-5V); DIL08; PARTNO ATTINY85-20PU-ND
Z1, Z2: MOUNTINGHOLE2.0; MOUNTINGHOLE_2.0_PLATED
Z3, Z4: FIDUCIAL; FIDUCIAL_1MM

Connections:
B0: J4.4, U2.5 ((MOSI/DI/SDA/AIN0/OC0A/OC1AN/AREF/PCINT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)
B1: J4.3, R6.1, U2.6 ((MISO/DO/AIN1/OC0B/OC1A/PCINT1)PB1)
B2: J4.2, U2.7 ((SCK/USCK/SCL/ADC1/T0/INT0/PCINT2)PB2)
B3: J3.2, R5.1, U2.2 ((XTAL1/CLKI/OC1BN/ADC3/PCINT3)PB3)
B4: J3.3, R4.1, U2.3 ((XTAL2/CLKO/OC1B/ADC2/PCINT4)PB4)
D+: D3.C, J1.3, R4.2
D-: D4.C, J1.2, R5.2, R7.2
GND: C1.2, C3.2, D3.A, D4.A, J1.5, J2.2, J3.4, LED1.K (C), LED2.K (C), R1.1, S1.1 (S), S1.2 (S1), U1.4 (GND), U2.4 (GND)
unnamed: LED1.A, R6.2
unnamed: LED2.A, R3.1
unnamed: C2.2, R1.2, R2.1, U1.7 (FEEDB)
RESETN: J3.1, S1.3, S1.4 (P1), U2.1 ((RESETN/DW/ADC0/PCINT5)PB5)
VBAT: D1.A, J2.1, J5.1
VBUS: D2.A, D5.A, J1.1, J6.1
VCC: C2.1, C3.1, D5.C, J4.1, R2.2, R3.2, R7.1, U1.1 (OUT), U2.8 (VCC)
VIN: C1.1, D1.C, D2.C, U1.8 (INPUT)

Notes on the sheet:
Adafruit Trinket 5V Modifed by UCSD
[ see http://adafruit.com/produts/1501 ]
SRD 9/14
Adafruit design modifed by SRD, at UCSD, CSE, NVSL Lab for educational use. Covered by Creative Commons Copyright via Adafruit.
(Selective load for 3-5V)
Selectively load R2 to adjust VCC. ~305K 1% for 5V USB power ~170K 1% for 3.3V operation ~143K 1% for 3.0V etc. vout=~1.235 x (1+R2/100K) http://www.micrel.com/_PDF/mic2950.pdf 29V Max input on VBAT. Can use 220 Ohm on LEDs when running at 3.3V with plenty of power. D1 protects the battery in case 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
Connector tails viewed from the back. -->
Many load options here: This is a Universal thorugh hole version of the Trinket covering all power options. Look for separate break out sheets for specific power supply variants. If all components are installed, just make sure R2 sets the regulator V correctly. U1,C1,C2,R1,R2,D1,D2 and J2 only need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

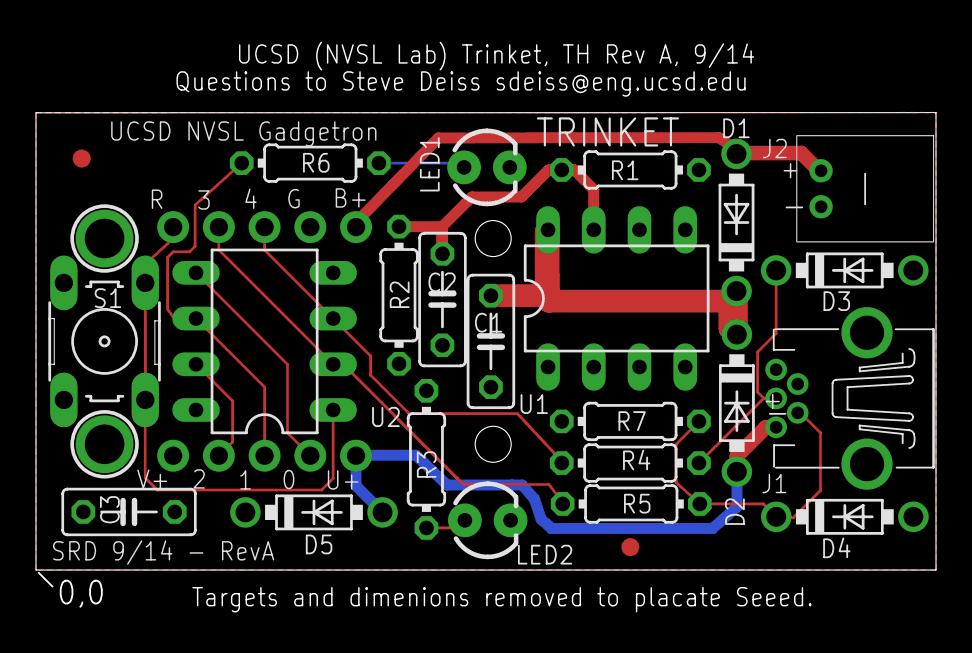
[picture p91: board TinyDuino.brd from above]

Board: 2 copper layers, 50.0 x 26.3 mm, 30 parts (0 on the bottom side), 16 nets.
