NVSL/Quadcopters/Button-and-Light/flashlight.brd

## EAGLE design Button-and-Light/flashlight.brd (2014-10-08)

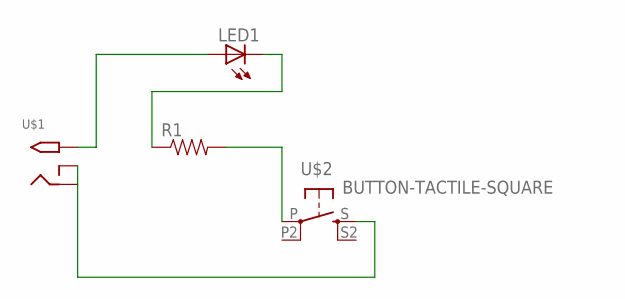
[picture p92: schematic flashlight.sch]

Parts:
LED1: LED5MM
R1: RESISTORAXIAL-0.3; AXIAL-0.3
U$1: 2.1MMJACKTHM; PJ-102A
U$2: BUTTON-TACTILE-SQUARE; BUTTON-TACTILE-SQUARE-ADAFRUIT1010

Connections:
unnamed: R1.P$2 (2), U$2.P
unnamed: LED1.K (C), R1.P$1 (1)
unnamed: LED1.A, U$1.TIP
unnamed: U$1.RING, U$1.RING_SW, U$2.S

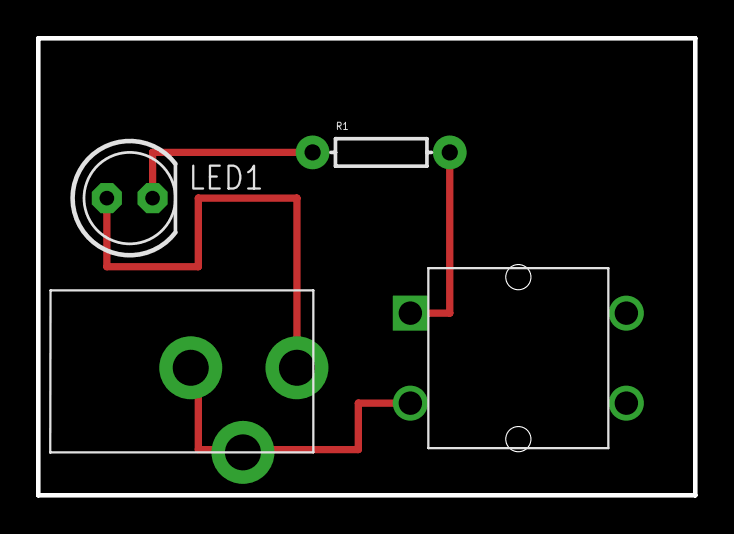
[picture p93: board flashlight.brd from above]

Board: 2 copper layers, 36.5 x 25.4 mm, 4 parts (0 on the bottom side), 4 nets.
