NVSL/Quadcopters/(commit log)

2014-10-08 Initial materials
    [flashlight-smd.brd, flashlight-smd.sch, flashlight.brd, flashlight.sch]
2014-10-12 Reorg and bom scipt
2014-10-13 Adding a project diretory for the Controller subsystem.
    parts.txt contains a BOM for the ATMEGA128RFA1 development board.
    notes.txt contains my notes and thoughts for the project
    Other directories are names with their contents
    [ATmega128RFA1-DevBoard.brd, ATmega128RFA1-DevBoard.sch]
2014-10-14 Added hacked version of MultiWii
    [config.h]
2014-10-14 Fixed MutliWiiConf flatlining
    The main problem was in def.h, I didn’t add my sensor so it did #define
    ACC 0, causing absolutely zero sensors to get polled.
2014-10-17 Adding controller schematic and controller library. Will explain in webpage update or in next notes checkin
    DR
    [ATmega128RFA1-DevBoard.brd, ATmega128RFA1-DevBoard.sch, controller_v1.sch]
2014-10-17 In the controller, adding a partially routed PCB.
    [controller_v1.brd, controller_v1.sch]
2014-10-19 new slides. More materials
    [TinyDuino-noboard.sch, TinyDuino.brd, TinyDuino.sch]
2014-10-20 Create Motor Control
2014-10-20 Finished first version of of the controller board, all of the way to routing Stil need to pass checks for the schematic, but i will ask about those in class today.
    [controller_v1.brd, controller_v1.sch]
2014-10-21 Added support for the ATmega128RFA1 MCU in MultiWii
    MultiWii can now be compiled targeting the ATmega128RFA1 Dev board. Note
    that there is a bug in the avr-libc 1.7.0 contained in the toolchain
    provided by WINAVR so the toolchain needs to be upgraded with the
    avr-libc version 1.8.1 .
2014-10-21 Got accelerometer working
    Was really simple, just a scaling issue. MultiWiiConf was really
    unhelpful debugging it though.
2014-10-21 Added L3GD20 Gyroscope support
    [config.h]
2014-10-23 Adding Voltage Regulator Datasheet
2014-10-26 Adding my work for this Saturday (10/25/2014)
    Added Devices and Footprints for:
    Gimbal Mount
    Gimbal Connector
    LCD Mount
    These can be found in the Controller.lbr file. In addition, I created a
    Gimbal_test schematic and board so I can print a test run PCB because we don't
    have any datasheets for the gimbals.
    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
    [Gimbal_test.brd, Gimbal_test.sch, controller_v2.brd, controller_v2.sch]
2014-10-27 Added a library file and power supply schematic
    [power_supply.sch]
2014-10-27 Fixed the pin ordering in the NHD lcd in the controller library
2014-10-27 Fixed Pin 10 on the LCD (Was GND, now is VDD)
2014-10-27 updated power_supply schematic and board files
    [power_supply.brd]
2014-10-28 IMU parts library, started Gyro
    Perhaps we should combine our libraries if anyone else is making parts?
2014-10-28 Added L3GD20H gyro eagle part
    Pins are all named assuming use of I2C and not SPI to make it easier to
    read.
2014-10-28 Revert "IMU parts library, started Gyro"
    This reverts commit c061a0d3cf927c49f59623105b917cd7ebd90274.
2014-10-29 Switched my symbols grid to 0.1inch
    That way it lines up with Eagle and microbuilder libraries
2014-10-29 Started gyro and accel schematic
    [board.sch]
2014-10-29 Finished gyro portion of schematic
    [board.sch]
2014-10-29 I wired the gyro wrong
    The picture describing the pads was upside down
2014-10-31 Motor Schematics
    [motor control.brd, motor control.sch]
2014-11-01 Changes to the Power Supply
2014-11-03 ISR vector naming error fix
    There was an error in the naming of the ISR vectors for the Serial
    interrupts that caused no communication between MultiWiiconf GUI and
    MultiWii.
2014-11-04 Reviewer tags in library
    [board.sch]
2014-11-04 QuadX, not quadp
    [config.h]
2014-11-04 Updated the POT package
    [power_supply.brd, power_supply.sch]
2014-11-05 Adding Controller versions v3 and v4. Both versions have two antennas, one for the RF Amplifier, and the second is the chip antenna. However, they are different in that the V4 design places them on o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
    The V5 board (next commit) will remove the Amplifier, and keep the chip
    antenna. Based on our range tests, we feel that the amplifier is uncessary and
    is too risky for the first version of the board
    [controller_v3.brd, controller_v3.sch, controller_v4.brd, controller_v4.sch]
2014-11-06 Adding v5 of the controller board, which only has one antenna
    [controller_v5.brd, controller_v5.sch]
2014-11-06 Breakout board for gyro and accelerometer
    Yes it’s ugly.
    [board.sch]
2014-11-06 Motor Driver Board
    Uploading the motor driver board.
    [motor control.brd, motor control.sch, motorboard.brd, motorboard.sch]
2014-11-07 Small changes on pcb
    [motorboard_v1.1.brd, motorboard_v1.1.sch]
2014-11-07 Added MCU schematics and board
    These ones can be programmed by the AVR Pocket Programmer
    [ATmega128RFA1-DevBoard-rev2.routed.brd, ATmega128RFA1-DevBoard-rev2.routed.sch, ATmega128RFA1-DevBoard.routed.brd, ATmega128RFA1-DevBoard.routed.sch]
2014-11-09 Adding Master schematic
    [master.sch]
2014-11-09 In the controller, finished connecting unconnected pins and Passed DRC using the Seeedstudio DRC files.
    [controller_v5.brd, controller_v5.sch]
2014-11-10 Adding RF communication to MultiWii, Wii...
    RF internal transceiver communication of the ATmega128RF was integrated
    to MultiWii. Now MultiWii can receive data from de controller/joysticks.
    I will be adding an example of the data format needed by the transmitter
    soon.
    [config.h]
2014-11-10 Added additional resistors to the gimbals to create a resistor ladder and meet the ADC swing voltage requirements.
    Also, cleaned up some of the board routing.
    [controller_v5.brd, controller_v5.sch]
2014-11-11 Brushless Motor Presentation
    Added ppt slides about BLDC
2014-11-12 Gerber Files
    Gerber Files
2014-11-12 Example of Basic Chat to Multiwii
    Added an example of how RF communication could be handled between the
    controller and MultiWii. The example contains the frame of data that
    MultiWii is expecting to receive.
2014-11-12 Motors problem fix
    PWM registers where modified to match the pins we are using in this
    board. Also a correction to drive brushed motors instead of brushless
    was made.
2014-11-13 adding master v2
    [master-v2.brd, master-v2.sch]
2014-11-13 changes to master-v2
    [master-v2.brd, master-v2.sch]
2014-11-14 Change motor pins in master v2
    Changed Pin enumeration for motors. There was one conflict with one Led
    so it was changed to another pin. Also routing of those pins was done.
    [master-v2.brd, master-v2.sch]
2014-11-14 Adding design files for controller v5, and controller v6.
    Controller v5 has holes milled in the center of the board (which costs
    substantially more). Controller v6 uses the board outline to create these holes
    (there are no holes in the middle, just a cut into the board). I've added all of
    the design files that I submitted to 4PCB and passed through FREEDFM.
    In addition, I've added the CAM file job that I used to create these files. It
    generates a GERBER file and EPS file of the board layout. 4PCB wanted the GERBER
    File, but I found that the EPS file was easier for me two view. They contain
    identical information.
    [controller_v6.brd, controller_v6.sch]
2014-11-15 Motors Pin configuration change
    There was another another change in the motor pin outputs. The problem
    was that there was a motor pin output in PB7 when the bootloder also
    defines this pin as an output and turns it on when a program is being
    downloaded, and we definitely don't want to have a motor spinning each
    time we download a new program.
    Also The led that indicates when to quadcopter is armed or disarmed was
    changed to pin PB6.
    [config.h]
2014-11-15 Forgot to add my IMU board
    [board.brd]
2014-11-16 Adding Debug pins
    Changed Motor pin numbers and added Debug pins in the schematic.
    [master-v2.brd, master-v2.sch]
2014-11-18 my master and LBR changes plus SMD power supply
    [master_brandon.brd, master_brandon.sch, power_supply_smd.sch]
2014-11-18 worked on my layout. The rest can be auto-routed
    [master_brandon.brd]
2014-11-18 Continued working on my layout
    [master_brandon.brd]
2014-11-19 Added SMD version
    Added SMD version
    [motorboardsurface.brd, motorboardsurface.sch]
2014-11-20 Adding master v.1 with SMD darlington
    I went trought Brandon's design mostly. Used autorouter except motor
    connections
    [master_muhsin_v1.brd, master_muhsin_v1.sch]
2014-11-20 Adding another master board
    ...
    [master_jorge.brd, master_jorge.sch]
2014-11-21 DRC Check changes
    Updating master_jorge board with some DRC checks.
    [master_jorge.brd, master_jorge.sch]
2014-11-21 updated Brandon's Master
    [master_brandon.brd, master_brandon.sch]
2014-11-22 Updating Silkscreen
    Updating silkscreen of master_jorge
    [master_jorge.brd, master_jorge.sch]
2014-11-24 Definitions for our new accelerometer
    It doesn’t work
    [config.h]
2014-11-27 Finished routing my board
    [master_brandon.brd]
2014-11-28 Adding New schematic/board
    Adding new schematic and board. The new board contains a different
    border line for placing the motors directly in the pcb.
    [master_jorge2.brd, master_jorge2.sch]
2014-11-29 Updating some designs
    [master_jorge.brd, master_jorge.sch, master_jorge3.brd, master_jorge3.sch]
2014-11-29 Updating again
    Making some changes that I forgot in the previous commit
    [master_jorge.brd, master_jorge2.brd, master_jorge3.brd]
2014-11-29 Started my version of the quadcopter board Forgot to commit any of this earlier
    I used the new IMU chip on this one
    [master_taylor.brd, master_taylor.sch]
2014-11-29 Routed most of VBAT, GND, and 3.3V
    [master_taylor.brd, master_taylor.sch]
2014-11-30 Routing is almost there...
    [master_taylor.brd, master_taylor.sch]
2014-11-30 Board all routed
    [master_taylor.brd]
2014-11-30 Modified quad wing so there is less area under each prop to block thrust
    [master_taylor.brd]
2014-11-30 Fixed some minor ERC errors
    Adjusted wing fins.
    [master_taylor.brd, master_taylor.sch]
2014-12-01 Fixed DRC and ERC errors
    The downside to handrouting.
    [master_taylor.brd]
2014-12-01 Uploading v4
    Uploading v4
    [master_muhsin_v4.brd, master_muhsin_v4.sch]
2014-12-01 Devon's mainboard and stripped down power supply
    [master_devon.routed.brd, master_devon.routed.sch, power_supply_stripped_th.brd, power_supply_stripped_th.sch]
2014-12-02 Fixed main board
    Hand routed some traces. Did some pin swapping. Now 2.5 x 2.5 inches.
    [master_devon.routed.brd, master_devon.routed.sch]
2014-12-02 Revert "Fixed main board"
    This reverts commit e8d481ade4fad3f727996ef615af2e559dd81647.
    [master_devon.routed.brd, master_devon.routed.sch]
2014-12-02 Updated library and rename
    [master_devon.brd, master_devon.sch]
2014-12-02 Extended pads on the LSM9DS0, changed quad wing
2014-12-02 IMU has name and value
    [master_taylor.brd, master_taylor.sch]
2014-12-02 Take 2 on my schematic
    Deleted some unnecessary parts
    Made crystal and antenna placement suck less
    [master_taylor2.brd, master_taylor2.sch]
2014-12-02 Version 2 routed
    Layed out crystal and antenna in accordance with the Cult of Sparkfun
    Added keepouts to IMU because of Jorge's recommendation
    Added keepout to antenna to not disturb the ether wind.
    [master_taylor2.brd, master_taylor2.sch]
2014-12-02 Changed outline a bit to reduce weight
    [master_taylor2.brd]
2014-12-02 Hand routed motors
    [master_taylor2.brd]
2014-12-03 Made board smaller, fixed VDD->3.3V issue
    [master_devon.routed.brd, master_devon.routed.sch]
2014-12-03 More tweaks, I don't even remember what I did
    [master_taylor2.brd]
2014-12-03 Added all-seeing eye to ward off evil electrons
    [master_taylor2.brd]
2014-12-03 Moving all my mess to a folder
    [master_jorge.brd, master_jorge.sch, master_jorge2.brd, master_jorge2.sch, master_jorge3.brd, master_jorge3.sch, master_jorge3newIMU.brd, master_jorge3newIMU.sch]
2014-12-03 Updated master_brandon
    [master_brandon.brd, master_brandon.sch]
2014-12-03 Added caps near each motor
    [master_taylor2.brd, master_taylor2.sch]
2014-12-03 Spaced out headers a bit
    [master_taylor2.brd]
2014-12-04 Sparkfun's electrolytic footprint seemed sketchy so I switched to microbuilder
    [master_taylor2.brd, master_taylor2.sch]
2014-12-04 Some updates
    Some updates to my schematic and my board
    [master_jorge3newIMU.brd, master_jorge3newIMU.sch]
2014-12-04 Added Dimensions
    [master_brandon.brd]
2014-12-05 Added LSM9DS0 definitions to MultiWii. Does not work perfectly in MultiWiiConf, looks like an accelerometer axis is missing.
    [config.h, master_taylor2.brd, master_taylor2.sch]
2014-12-11 Controller has calibrated values
2014-12-12 Added calibration to controller
    Hold the top right button to calibrate it
2014-12-12 Integrated my controller calibration code with Jorge's transmit code
2014-12-12 Bug in CRC checking
    [RadioFunctions.h, TestReceive.ino]
2014-12-12 MultiWii spins up!
    -CRC fix everywhere
    -Changed MultiWii RF channel to 21
    -Made MultiWii PWM init stuff work
    [config.h]
2014-12-12 ESC MultiWii changes
    Motors still idling at low speeds instead of off
    [config.h]
2014-12-14 Sensor definitions for LSM9DS0 on new board
    It’s commented out
    [config.h]
2014-12-16 I2C errors FIX
    [config.h]
2014-12-19 Making minor changes to the controller v6 library
    [controller_v6.brd]
2014-12-23 Some fixes from the last test.
    [config.h]
2015-02-03 Rev 0 of the faceplate for the new controller
    [controller_faceplate.dxf]
2015-02-04 Solder Practice Board
    [solder_test.brd]
2015-02-12 Adding REV1 board
    Adding revision 1 of the PCB with modifications on the motor power
    driver schematic.
    [master_jorge.brd, master_jorge.sch, master_jorge2.brd, master_jorge2.sch, master_jorge3.brd, master_jorge3.sch, master_jorge3newIMU.brd, master_jorge3newIMU.csv]
2015-02-15 Finish routing REV1
    Just missing increase arm size for motors.
    [master_jorge3newIMU.brd, master_jorge3newIMU.sch]
2015-02-16 Uploading Finished QuadCopter PCB REV1
    [UCSD_QuadCopter_Rev1.brd, UCSD_QuadCopter_Rev1.sch]
2015-02-25 Moved the controller code to a more sensible place
    [controller_v6.brd]
2015-02-26 Accidentally committed these
    [controller_v6.brd]
2015-03-05 Controller supports the sparkfun LCD screen Gimbal values are not symmetric, had to calibrate for centers Modified controller library for better gimbal footprints
2015-03-07 Swapped two motor pins
2015-03-09 Print out calibration when finished
2015-03-09 Made controller outline more curvy Gimbal outlines are internally routed Switched to 3.3V screen Added bottom plating
    [controller.brd, controller.sch, controller_bottom_plate.brd, controller_bottom_plate.sch]
2015-03-16 Moved gimbals up for comfort Made connection board
    [controller.brd, controller.sch]
2015-03-16 Made new eagle project for controller connector board Made new JST connect device that matches the JST connector (not sure why it didn't originally)
    [controller_connect_board.brd, controller_connect_board.sch]
2015-03-16 Routing and rubouts
    [controller_connect_board.brd]
2015-03-16 Controller connect board has only the board, no acrylic stuff Added connector board to library so it matches up with acrylic cutouts
    [controller_connect_board.brd]
2015-03-16 Moved bottom acrylic plate to separate file
    [controller_bottom.brd, controller_bottom.sch]
2015-03-16 I'm not sure what the changes are but it should be ready
    [controller_bottom.brd]
2015-03-16 Sparkfun LCD you will not get me this time! Added cutout for the upper through-hole stuff. If this doesn't sit flush against the faceplate I will eat....my....hat?
2015-03-16 Now it should be ready controller_bottom was not supposed to have the LCD cutout Added dimension to layer 20 in connector board
    [controller_bottom.brd, controller_connect_board.brd]
2015-03-16 Organized eagle files better
    Top: top faceplate
    Bottom: bottom faceplate (both acrylic)
    connector_board: PCB to connect stuff to
    [controller.brd, controller.sch, controller_bottom.brd, controller_top.brd, controller_top.sch]
2015-03-18 Bug in reading calibration data! Extreme values should be more accurate now
    Added dead zone
    [Controller.ino]
2015-03-19 First test of connector board Ground and VDD were reversed on gimbal pins Made holes bigger
    [controller_bottom.brd, controller_connect_board.brd, controller_connect_board.sch, controller_top.brd]
2015-03-19 FORGOT THE BUTTON WOW WOW I...WOW
    [controller_connect_board.brd, controller_connect_board.sch]
2015-03-19 Added rubouts for stuff
    [controller_connect_board.brd]
2015-03-19 Had to make some holes larger on button for board mill Violated tRestrict
    [controller_connect_board.brd, controller_connect_board.sch]
2015-03-20 Latest Multiwii Code & Schematic
    Uploading latest code & Schematic (Jorge).
    + Correct IMU ACC & GYRO ORENTATIOn.
    + Adding some parameters to EEPROM by default..
    + Correct Motors Pin Output for (Rear_L, Rear_R, Front_L, Front_R)
    [UCSD_QuadCopter_Rev1.brd, UCSD_QuadCopter_Rev1.csv, UCSD_QuadCopter_Rev1.sch, config.h]
2015-03-21 Moved both gimbals 5mm closer to the edge for comfort
    [controller_top.brd]
2015-03-21 Nudged sparkfun board to the right a bit to make room for battery pack
    [controller_bottom.brd]
2015-03-21 Tweaked a bit so it would work for new assembled controller
2015-03-24 Added dxf files Changed resistor values to 5.6k to be consistent with BOM
    [controller_bottom.dxf, controller_connect_board.brd, controller_connect_board.sch, controller_top.brd, controller_top.dxf]
2015-04-07 Adding I2C Slides
2015-04-26 Adding Stable Flying Version of MultiWii and GUI
    MultiWii
    +Added FailSafe
    +Added print() for debugging
    +Switched one PWM pin
    +Enabled and included Magnetometer routines
    Multiwii Conf GUI
    +Fixed problem with Write to EEprom
    [config.h]
2015-04-28 Some clean Up
    [UCSD_QuadCopter_Rev1.brd]
